angler-robotics/angler-electrical/Hardware/V2/Block Diagrams/PDB.png

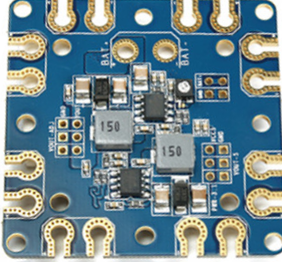
Hardware/V2/Block Diagrams/PDB.png
