angler-robotics/angler-electrical/Hardware/V2/Block Diagrams/XT60 plug.png

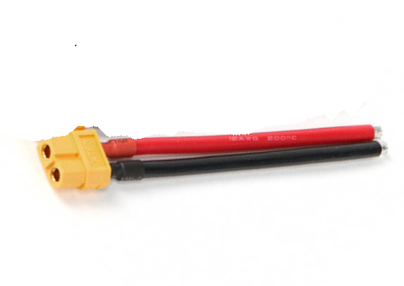
Hardware/V2/Block Diagrams/XT60 plug.png
