angler-robotics/angler-electrical/Hardware/V2/Block Diagrams/Block DiagramV2.pdf

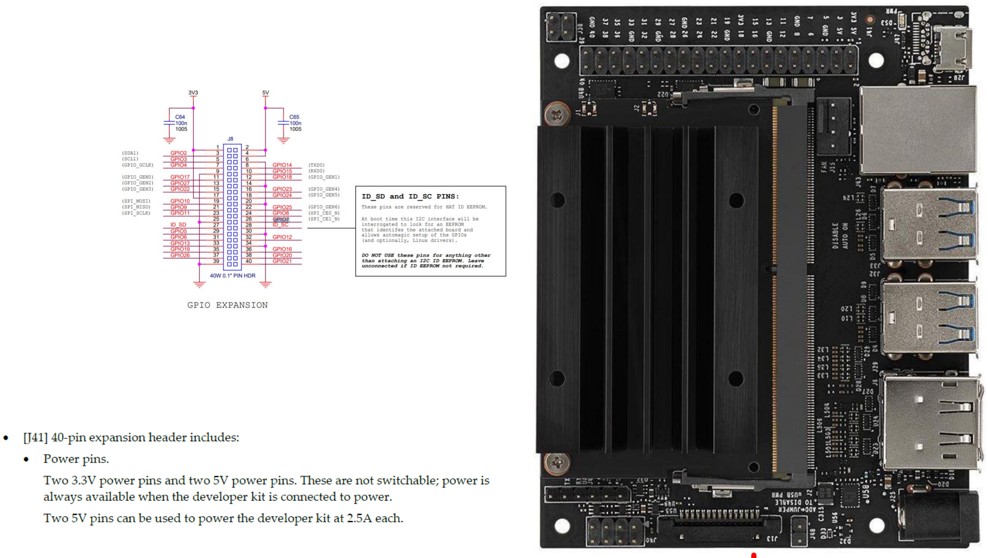
[picture p3: figure]

T100 Thruster | T100 Thruster | T100 Thruster | T100 Thruster | T100 Thruster | T100 Thruster

14.8V 8000mAh 4S1P 30C8000mAh 4S1P 30C

14.8V 8000mAh 4S1P 30C8000mAh 4S1P 30C

XT90 Parallel Adapter

### 2 male inputs 1 female

output

ESC | ESC | ESC | ESC | ESC | ESC

To Proto
Board

# AquaDrone Electrical Block Diagram V2

Power Distribution
Board

XT90 Male Wire Plug

Solder to BAT+ and
BAT- Thru Hole use
10AWG wires

Use bullet
connectors
3x

Use bullet
connectors
3x

Use bullet
connectors
3x

Use bullet
connectors
3x

Use bullet
connectors
3x

Use bullet
connectors
3x

XT60
Male
Wire
Plug

Solder

XT60
Male
Wire
Plug

Solder

XT60
Male
Wire
Plug

Solder

XT60
Male
Wire
Plug

Solder

XT60
Male
Wire
Plug

Solder

XT60
Male
Wire
Plug

Solder

XT60 Female Wire Plug

XT60 Female Wire Plug

XT60 Female Wire Plug

XT60 Female Wire Plug

XT60 Female Wire Plug

To Proto
Board

To Proto
Board

To Proto
Board

To Proto
Board

To Proto
Board

Jetson Nano Dev Kit

H3AAH-4006G

XT60
Plug

Wire

Male

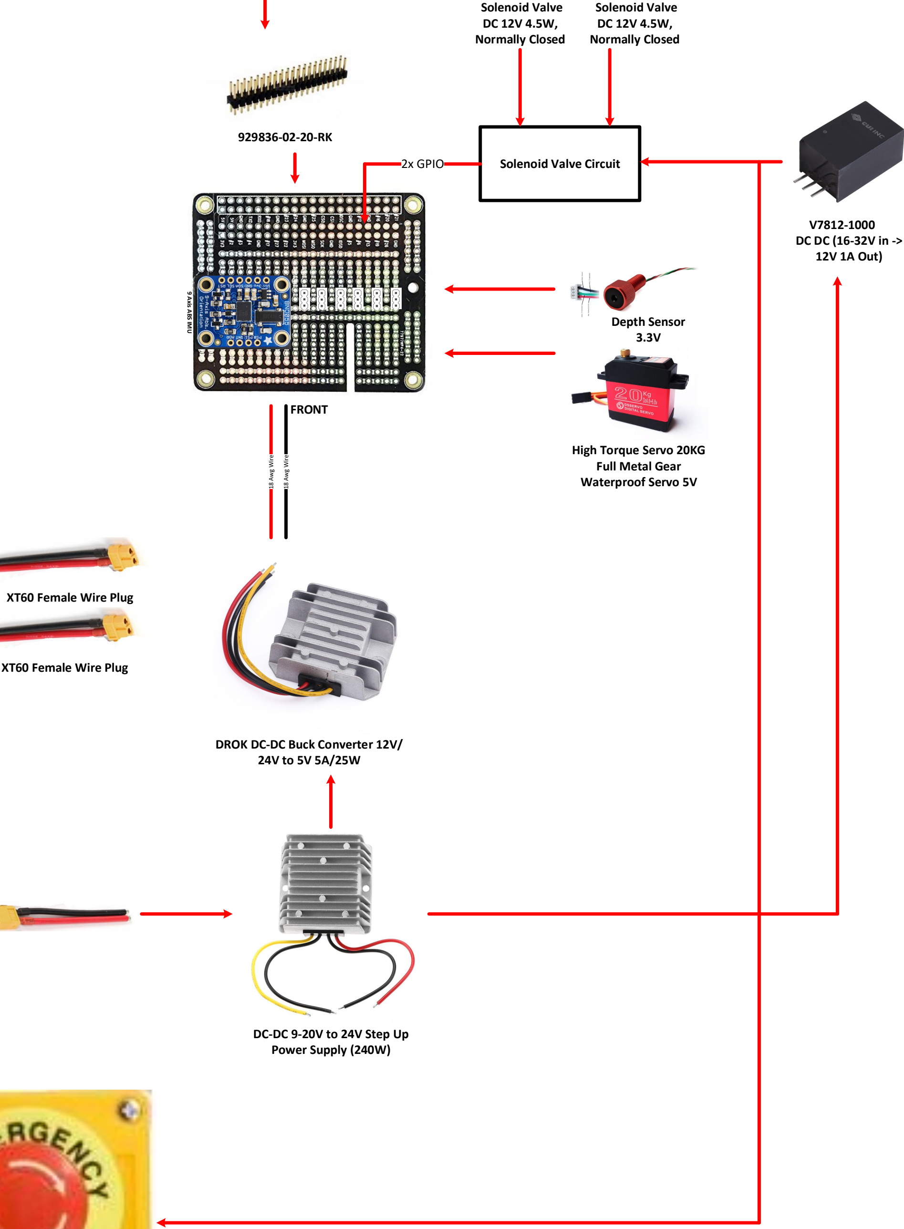
[picture p4: figure]
Depth Sensor 3.3V; XT60 Female Wire Plug; FRONT; 9 Axis ABS IMU; DROK DC-DC Buck Converter 12V/; High Torque Servo 20KG Full Metal Gear Waterproof Servo 5V; 2x GPIO; Solenoid Valve Circuit; V7812-1000 DC DC (16-32V in -> 12V 1A Out); Solenoid Valve DC 12V 4.5W, Normally Closed; DC-DC 9-20V to 24V Step Up Power Supply (240W)

# 24V to 5V 5A/25W ¹⁸ Awg Wire 18 Awg Wire

ZED Mini 5V / 380mA

USB 3.0

Jetson Is powered by the 2 5V pins on the

### 40 Piin header (each can draw 2.5A)

USB 2.0

Digital Battery Capacity
Checker

Digital Battery Capacity
Checker

Fuse + Fuse
Holder

Solder Solder

Fuse + Fuse
Holder

Solder Solder

Fuse + Fuse
Holder

Solder Solder

Fuse + Fuse
Holder

Solder Solder

Fuse + Fuse
Holder

Solder Solder

Fuse + Fuse
Holder

Solder Solder

H2a Hydrophone 3.5mm TRS audio cable

12V 100A Heavy Duty
Split Charge ON/OFF
Relay

Estop Button use NC (dpst) contacts

UGREEN USB
External Stereo
Sound Adapter 96
Khz
