angler-robotics/angler-electrical/Hardware/V1/Research/Battery Parameters.xlsx

# of Motors | 6
Max current draw per motor (A) | 12.5
Total current draw for motors (A) | 75
Curernt draw for other electronics (A) | 5 | I am being conservative here, 5A is more than what we will actaully need (1A will be our goal)
Total Current draw of the system (A) | 80
Number of Lipo cells | 4
Nominal Voltage (V) | 14.8
C Rating | 30
Mah Rating (MAh) | 8000 | Increase this number and flight time goes up
Max current draw that the Lipo can handle (A) | 240
%of load you will actaully use during normal operation | 30%
Flight Time/battery pack (min) | 20
#of battery packs | 2
Total Flight time (Min) | 40
Max power consumption (watts) | 1184 | this is important when choosing cable and wire guages
