angler-robotics/angler-electrical/Hardware/V2/Block Diagrams/Jetson nano.jpg

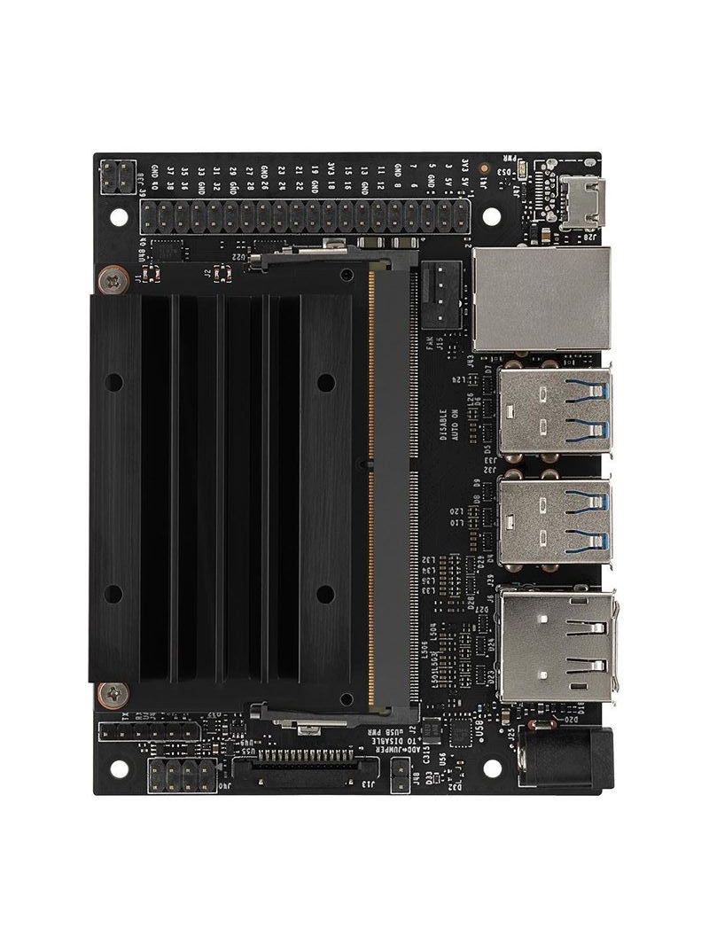
Hardware/V2/Block Diagrams/Jetson nano.jpg
