angler-robotics/angler-electrical/Hardware/V2/Block Diagrams/Motor.png

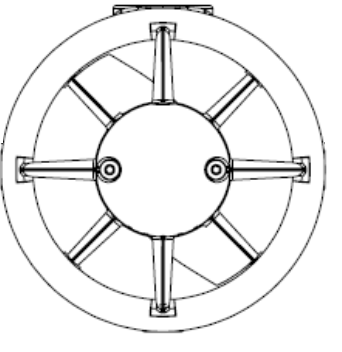
Hardware/V2/Block Diagrams/Motor.png
