angler-robotics/angler-electrical/Hardware/V2/Block Diagrams/Proto board connection.png

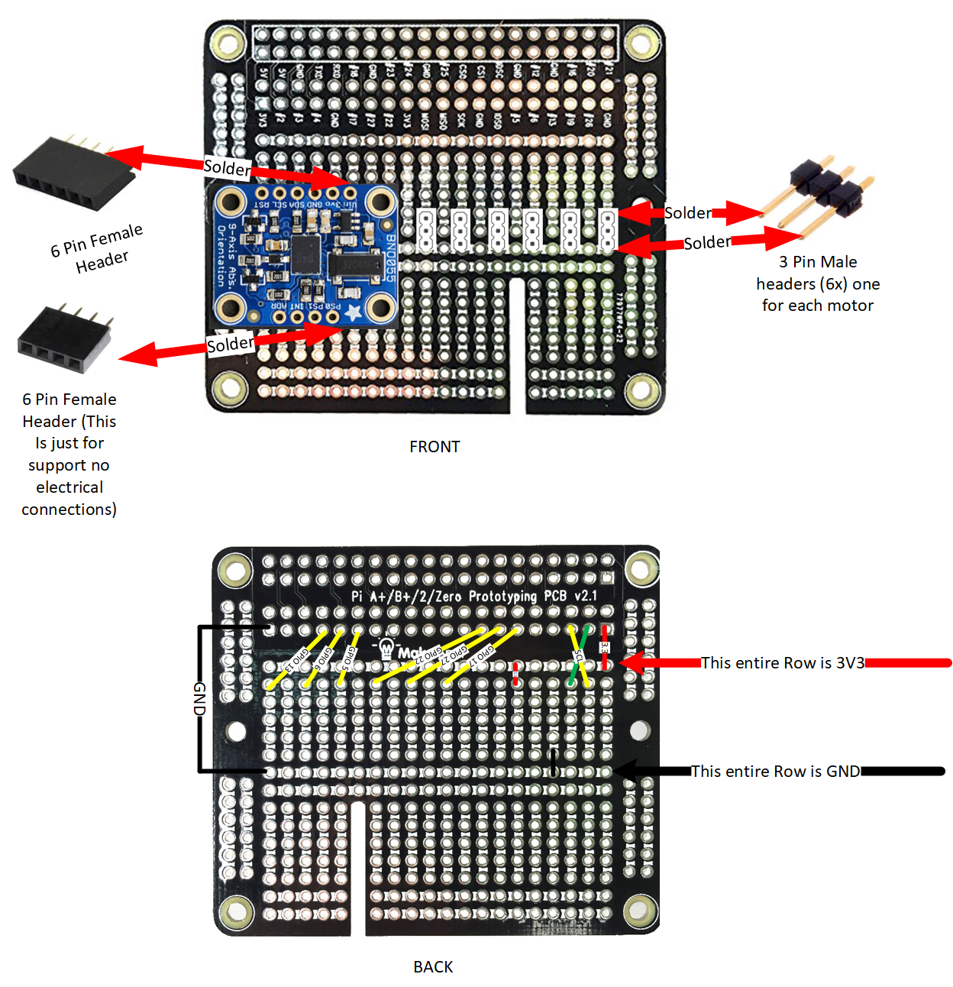
Hardware/V2/Block Diagrams/Proto board connection.png
