angler-robotics/angler-electrical/Hardware/V2/Block Diagrams/XT90 plug.png

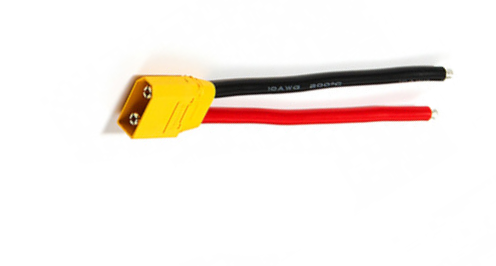
Hardware/V2/Block Diagrams/XT90 plug.png
