angler-robotics/angler-electrical/Hardware/V2/Main PCB V2/BOM/Angler_Main_PCB_V2.xlsx

PCB V2 BOM
Quantity | Designator | VALUE | MFG | MFG_PART_NO | Description | NOSTUFF | COST | Notes
1 | C1 | 4.7uF | Murata Electronics | GRM219R6YA475KA73D | CAP CER 4.7UF 35V X5R 0805 |  | 0.4
1 | C10 | 0.1uF | Yageo | CC0603KRX7R8BB104 | CAP CER 0.1UF 25V X7R 0603 |  | 0.14
1 | C11 | 2nF | Yageo | CC0603KRX7R9BB202 | CAP CER 2000PF 50V X7R 0603 |  | 0.14
1 | C12 | 750pF | Yageo | CC0603KRX7R9BB751 | CAP CER 750PF 50V X7R 0603 |  | 0.16
1 | C4 | 330uF | KEMET | ESL337M025AGMAA | CAP ALUM 330UF 20% 25V TH |  | 0.53
1 | C5 | 47nF | Yageo | CC0603KRX7R9BB473 | CAP CER 0.047UF 50V X7R 0603 |  | 0.14
1 | C8 | 22uF | Taiyo Yuden | TMK325B7226KMHP | CAP CER 22UF 25V X7R 1210 |  | 1.55 | Alternative C1210C226K4PACTU
1 | D6 | 100V 5A | Vishay | VSSAF510-M3/H | DIODE SCHOTTKY 100V 5A DO221AC |  | 0.55
1 | J13 | CONN HEADER VERT 40POS | Amphenol | 67997-140HLF | CONN HEADER VERT 40POS 2.54MM |  |  | Already Have
1 | J18 | 0705530002 | Molex | 0705530002 | CONN HEADER R/A 3POS 2.54MM |  | 1.47
1 | J25 | HEADER VERT 7POS | Wurth Electronics Inc. | 61300711121 | CONN HEADER VERT 7POS 2.54MM |  |  | Already Have
1 | J9 | Jetson Nano 40 Pin | Jetson | Nano | Jetson Nano 40 Pin Interface |  |  | Already Have
1 | L1 | 9.654µH | Eaton | DRQ125-100-R | INDUCT ARRAY 2 COIL 9.654UH SMD |  | 3.15
1 | R17 | 5K62 | Yageo | RC0603FR-075K62L | RES SMD 5.62K OHM 1% 1/10W 0603 |  | 0.15
1 | R18 | 84.5K | Yageo | RC0603FR-0784K5L | RES SMD 84.5K OHM 1% 1/10W 0603 |  | 0.15
1 | R19 | 1K07 | Yageo | RC0603FR-071K07L | RES SMD 1.07K OHM 1% 1/10W 0603 |  | 0.15
1 | R22 | 348R | Yageo | RC0603FR-07348RL | RES SMD 348 OHM 1% 1/10W 0603 |  | 0.15 | Alternative ‎ERJ-3EKF3480V‎
1 | R23 | 36K | Yageo | RC0603FR-0736KL | RES SMD 36K OHM 1% 0.15W 0603 |  | 0.15
1 | R24 | 0R013 | Susumu | PRL1632-R013-F-T1 | RES 0.013 OHM 1W 1206 WIDE |  | 1
1 | R65 | 4.53K | Yageo | RC0603FR-074K53L | RES SMD 4.53K OHM 1% 1/10W 0603 |  | 0.15
1 | SW1 | 100A 12VDC | Omron | G7EB-1A DC12 | RELAY GEN PURPOSE SPST-NO 100A 12VDC |  | 42.86
1 | U1 | BNO055 | Adafruit Industries LLC | BNO055 | IC BNO055 |  |  | Already Have
1 | U2 | DC DC 0.8-6V 10A | TI | LMZ12010TZ/NOPB | DC DC CONVERTER 0.8-6V 10A |  | 24.09
1 | U3 | LM3488MM/NOPB | TI | LM3488MM/NOPB | IC REG CTRLR MULT TOP 8VSSOP |  | 3.29
1 | U4 | DC DC CONVERTER 3.3V 2W | Recom Power | R-78E3.3-0.5 | DC DC CONVERTER 3.3V 2W |  | 3.86
1 | U6 | PCA9685PW,112 | NXP USA Inc. | PCA9685PW,112 | IC LED DRVR LIN DIM 25MA 28TSSOP |  | 3.46
2 | C7, C13 | 0.47uF | Samsung | CL10B474KO8NNNC | CAP CER 0.47UF 16V X7R 0603 |  | 0.14
2 | J1, J10 | XT90-M | DFRobot | FIT0588 | CONN XT90 MALE |  |  | Already Have
2 | J22, J26 | HEADER VERT 3POS | Wurth Electronics Inc. | 61300311121 | CONN HEADER VERT 3POS 2.54MM |  |  | Already Have
2 | J7, J11 | LiPo Cells (JST-XH) | JST Sales America Inc. | S5B-XH-A(LF)(SN) | CONN HEADER R/A 5POS 2.5MM |  | 0.43
2 | R28, R29 | 127K | Vishay Dale | CRCW0603127KFKEA | RES SMD 127K OHM 1% 1/10W 0603 |  | 0.15
2 | R36, R37 | 86.6K | Yageo | RC0603FR-0786K6L | RES SMD 86.6K OHM 1% 1/10W 0603 |  | 0.15
2 | R43, R44 | 47K | Yageo | RC0603FR-0747KL | RES SMD 47K OHM 1% 1/10W 0603 |  | 0.15
3 | C2, C3, C9 | 33uF | Nichicon | UPM2A330MPD1TD | CAP ALUM 33UF 20% 100V RADIAL |  | 0.18
3 | U5, U7, U8 | MCP3424-E/SL | Microchip Technology | MCP3424-E/SL | IC ADC 18BIT SIGMA-DELTA 14SOIC |  | 5.98
4 | LED1, LED2, LED3, LED4 | GREEN 0805 | Würth Elektronik | 150080VS75000 | LED GREEN CLEAR 0805 SMD |  | 0.26
6 | C14, C15, C17, C18, C21, C23 | 10uF | KEMET | C1608X5R1E106M080AC | CAP CER 10UF 25V X5R 0603 |  | 0.14 | Alternative ‎CL10A106MA8NRNC‎
6 | D1, D2, D3, D4, D5, D7 | S1GTR | SMC Diode Solutions | S1GTR | DIODE GEN PURP 400V 1A SMA |  | 0.17
6 | Q1, Q2, Q3, Q4, Q5, Q6 | 16mOhm @ 20A, 10V | ON Semiconductor | NTD5865NLT4G | MOSFET N-CH 60V 46A DPAK |  | 0.97
6 | R21, R71, R72, R75, R77, R79 | 100R | Yageo | RC0603FR-07100RL | RES SMD 100 OHM 1% 1/10W 0603 |  | 0.15
6 | U9, U10, U11, U12, U13, U14 | SN74LVC1G97DBVR | TI | SN74LVC1G97DBVR | IC CONFIG MULT-FUNC GATE SOT23-6 |  | 0.58
7 | R30, R33, R50, R57, R60, R68, R70 | 10K | Vishay Dale | CRCW060310K0FKEA | RES SMD 10K OHM 1% 1/10W 0603 | DNP |  | DNP
8 | ESC1, ESC2, ESC3, ESC4, ESC5, ESC6, ESC7, ESC8 | Basic ESC | Blue Robotics | BESC30-R3 | Basic ESC
8 | FH1, FH2, FH3, FH4, FH5, FH6, FH7, FH8 | Fuse Holder | Schurter Inc. | 0031.8231 | FUSE BLOK CARTRIDGE 600V 16A PCB |  | 2.89
8 | J2, J3, J4, J5, J6, J14, J16, J19 | 0705530001 | Molex | 0705530001 | CONN HEADER R/A 2POS 2.54MM |  | 1.12
8 | J8, J12, J15, J17, J20, J21, J23, J24 | TERM BLK 3 POS | TE Connectivity | 282834-3 | TERM BLK 3P SIDE ENT 2.54MM PCB |  | 2.9
8 | R14, R15, R40, R41, R42, R45, R46, R47 | 0R | Panasonic | ERJ-6GEY0R00V | RES SMD 0 OHM JUMPER 1/8W 0805 | DNP |  | DNP
8 | R31, R32, R38, R39, R48, R49, R63, R64 | 28.7K | Yageo | RC0603FR-0728K7L | RES SMD 28.7K OHM 1% 1/10W 0603 |  | 0.15
9 | R1, R2, R3, R4, R5, R6, R7, R8, R9 | 0R | Panasonic | ERJ-6GEY0R00V | RES SMD 0 OHM JUMPER 1/8W 0805 |  | 0.15
10 | C16, C19, C20, C22, C24, C25, C26, C27, C28, C29 | 0.1uF | KEMET | C0603C104M4RACTU | CAP CER 0.1UF 16V X7R 0603 |  | 0.14
29 | R10, R11, R12, R13, R16, R20, R25, R26, R27, R34, R35, R51, R52, R53, R54, R55, R56, R58, R59, R61, R62, R66, R67, R69, R73, R74, R76, R78, R80 | 10K | Vishay Dale | CRCW060310K0FKEA | RES SMD 10K OHM 1% 1/10W 0603 |  | 0.15
 |  |  |  |  | TOTAL |  | 184.89
