angler-robotics/angler-electrical/Hardware/V2/Main PCB V1/Traces-1.27mm Thick-Copper.DXF

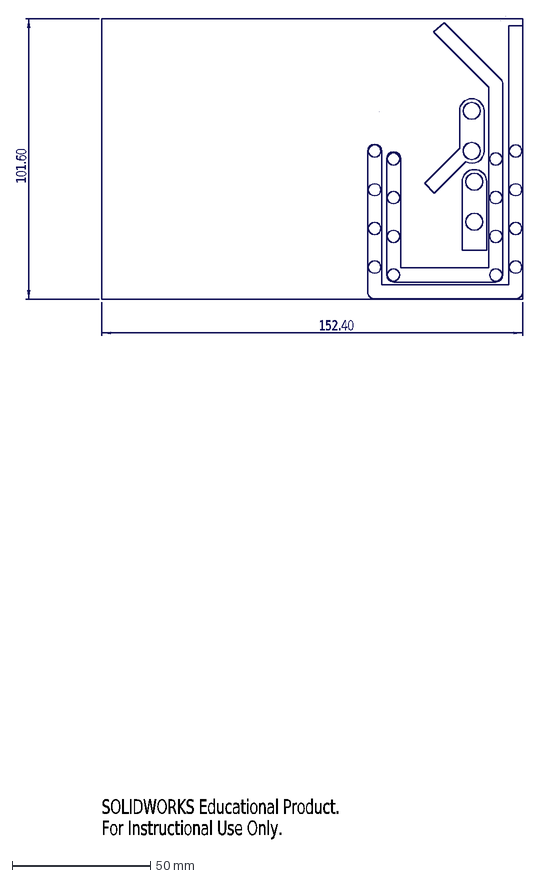
[picture p9: CAD file, 2020-01-24, an earlier design]
Hardware/V2/Main PCB V1/Traces-1.27mm Thick-Copper.DXF
152.40
101.60
SOLIDWORKS Educational Product.
For Instructional Use Only.
