angler-robotics/angler-electrical/(list of files, cad)

Other CAD files:
Hardware/V2/Main PCB V1/Traces-1.27mm Thick-Copper.SLDDRW
