angler-robotics/angler-electrical/Testing/Motor PWM Width - Thrust Relation.xlsx

PWM Signal Width | Thrust (pounds) | RPM | Thrust (kg)
1100 | -3.89 | 2869 | -1.768181818
1110 | -3.61 | 2987 | -1.640909091
1120 | -3.47 | 3110 | -1.577272727
1130 | -3.36 | 3061 | -1.527272727
1140 | -3.17 | 3057 | -1.440909091
1150 | -3.08 | 3184 | -1.4
1160 | -2.91 | 3810 | -1.322727273
1170 | -2.77 | 3841 | -1.259090909
1180 | -2.66 | 3771 | -1.209090909
1190 | -2.56 | 3690 | -1.163636364
1200 | -2.43 | 3631 | -1.104545455
1210 | -2.29 | 3571 | -1.040909091
1220 | -2.18 | 3497 | -0.990909091
1230 | -2.04 | 3411 | -0.927272727
1240 | -1.88 | 3321 | -0.854545455
1250 | -1.74 | 3241 | -0.790909091
1260 | -1.66 | 3141 | -0.754545455
1270 | -1.55 | 3071 | -0.704545455
1280 | -1.47 | 2960 | -0.668181818
1290 | -1.37 | 2871 | -0.622727273
1300 | -1.28 | 2771 | -0.581818182
1310 | -1.17 | 2653 | -0.531818182
1320 | -1.04 | 2531 | -0.472727273
1330 | -0.94 | 2430 | -0.427272727
1340 | -0.88 | 2311 | -0.4
1350 | -0.81 | 2201 | -0.368181818
1360 | -0.72 | 2090 | -0.327272727
1370 | -0.6 | 1961 | -0.272727273
1380 | -0.51 | 1831 | -0.231818182
1390 | -0.44 | 1711 | -0.2
1400 | -0.37 | 1586 | -0.168181818
1410 | -0.31 | 1440 | -0.140909091
1420 | -0.23 | 1278 | -0.104545455
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
