angler-robotics/angler-electrical/Hardware/V2/Main PCB V2/WBDesign4.pdf

## WEBENCH ® Design Report

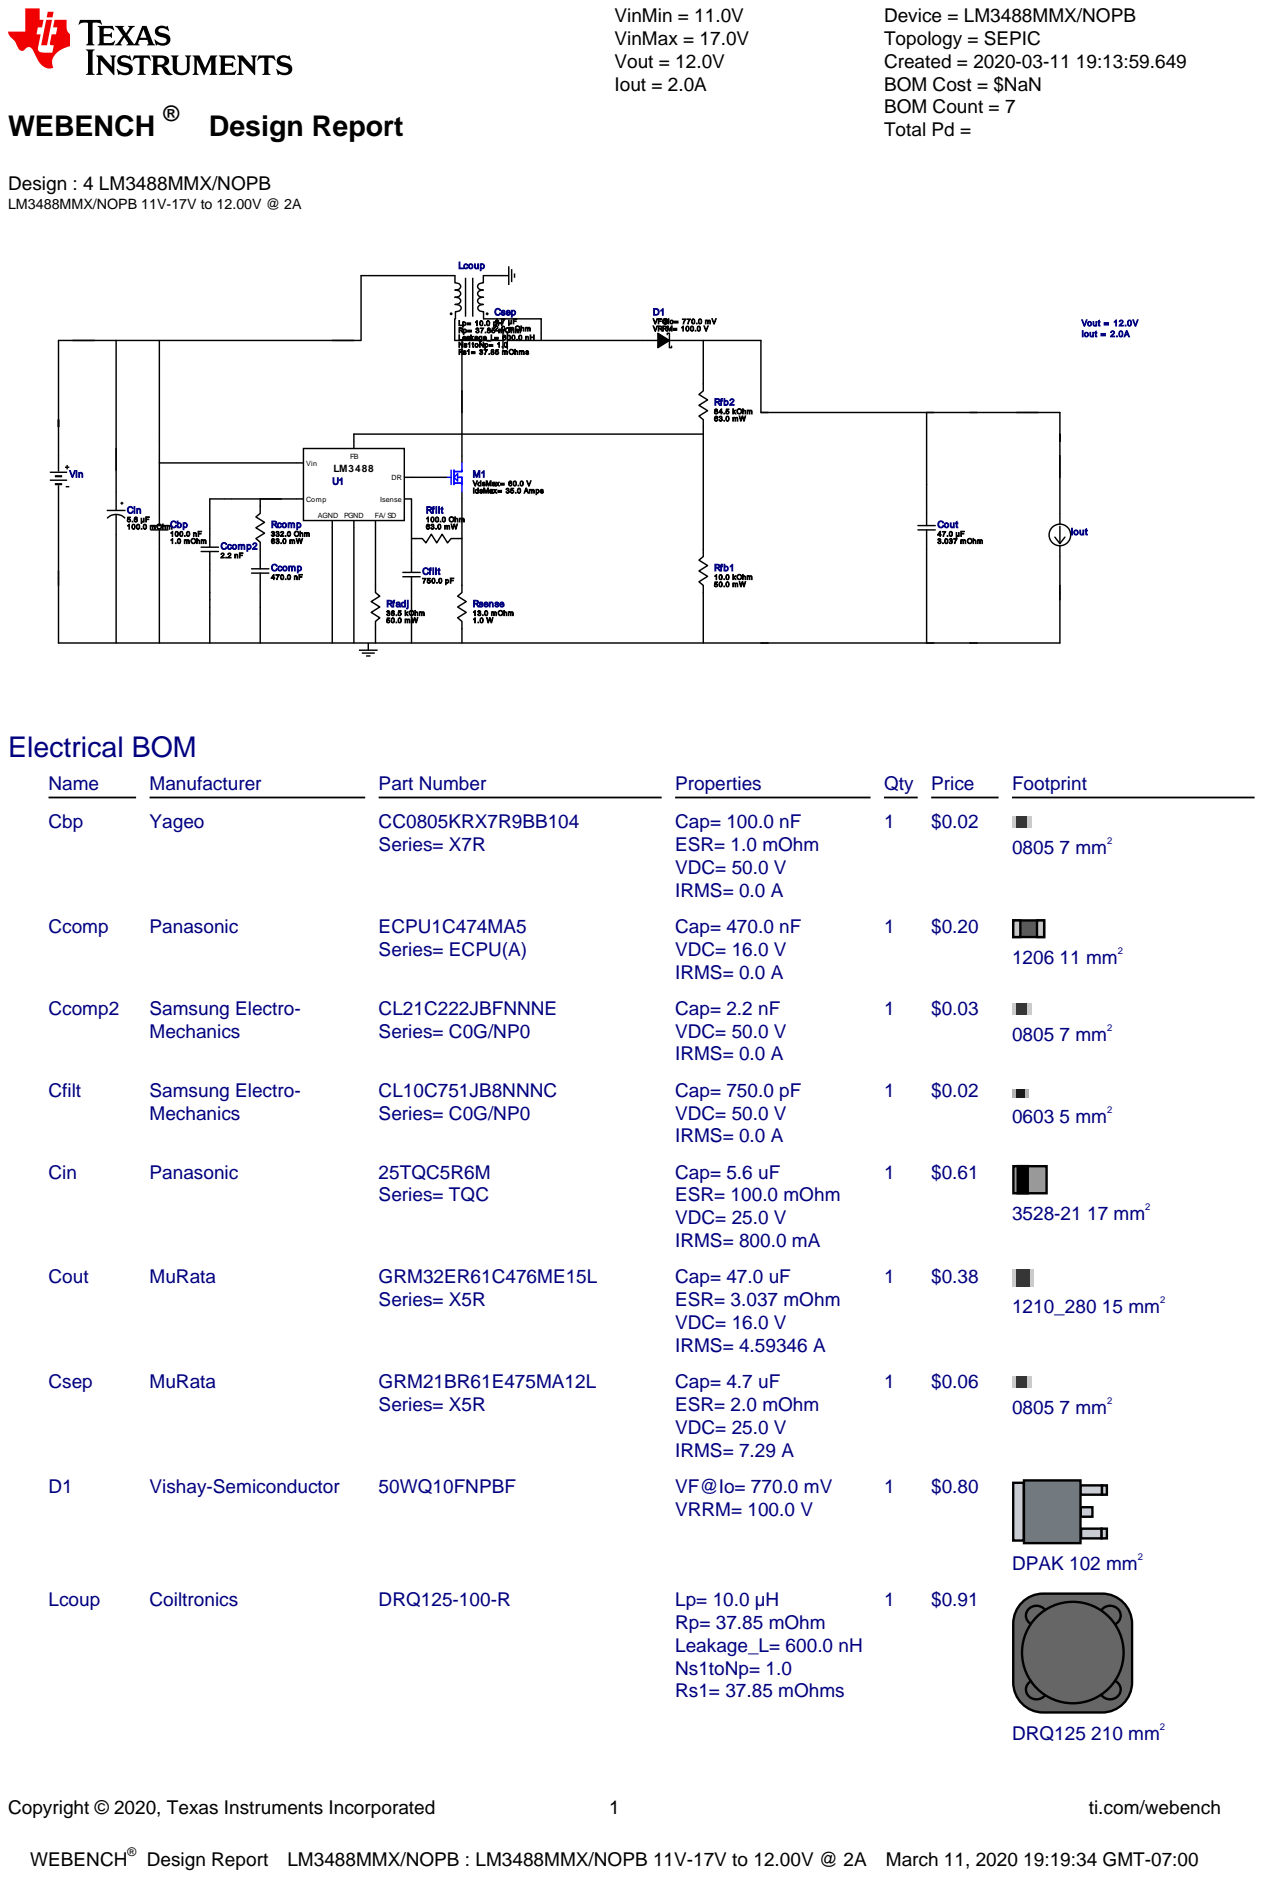
[picture p10: page 1]
Copyright © 2020, Texas Instruments Incorporated; ti.com/webench; WEBENCH®; Design : 4 LM3488MMX/NOPB LM3488MMX/NOPB 11V-17V to 12.00V @ 2A; VinMin = 11.0V VinMax = 17.0V Vout = 12.0V Iout = 2.0A; Cin 5.6 µF 100.0 mOhmCbp 100.0 nF 1.0 mOhm; Vout = 12.0V Iout = 2.0A; Cout 47.0 µF; 3.037 mOhm; Rfadj 36.5 kOhm; M1 VdsMax= 60.0 V IdsMax= 35.0 Amps; Rfb1 10.0 kOhm 50.0 mW; D1 VF@Io= 770.0 mV VRRM= 100.0 V; PGND; Vin; Comp; AGND; Isense; Ccomp 470.0 nF; Rcomp 332.0 Ohm 63.0 mW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

Device = LM3488MMX/NOPB
Topology = SEPIC
Created = 2020-03-11 19:13:59.649
BOM Cost = $NaN
BOM Count = 7
Total Pd =

Design Report LM3488MMX/NOPB : LM3488MMX/NOPB 11V-17V to 12.00V @ 2A March 11, 2020 19:19:34 GMT-07:00

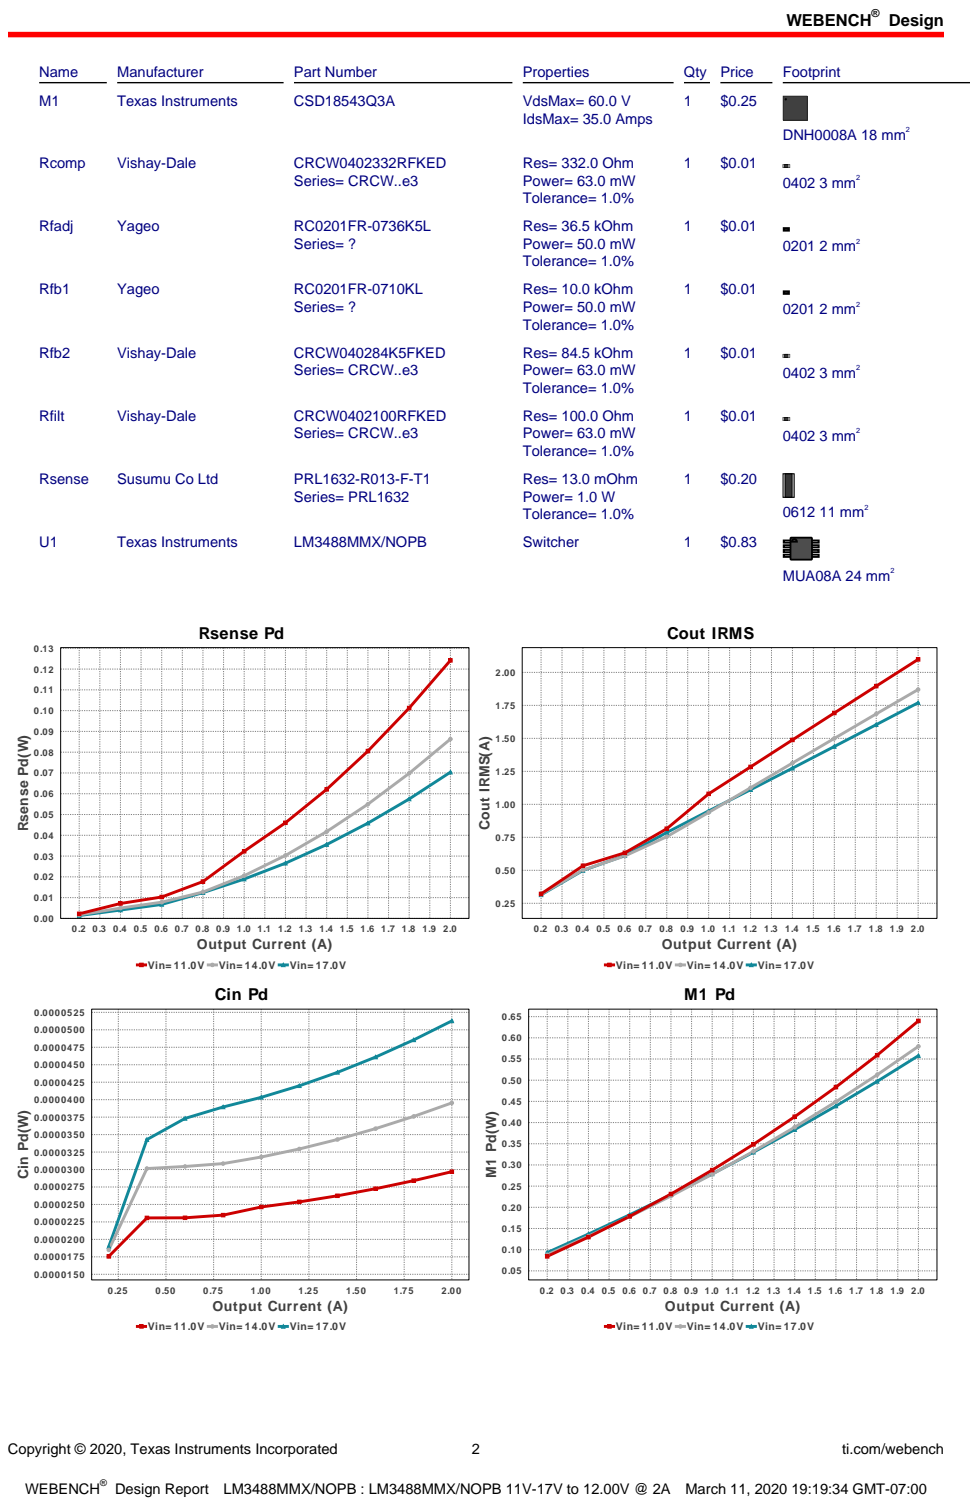
[picture p11: page 2]
Design; Copyright © 2020, Texas Instruments Incorporated; ti.com/webench; Name; Manufacturer; Part Number; Properties; Qty Price; Footprint; Texas Instruments; CSD18543Q3A; VdsMax= 60.0 V; IdsMax= 35.0 Amps; DNH0008A 18 mm²; Rcomp; Vishay-Dale; CRCW0402332RFKED; Series= CRCW..e3; Res= 332.0 Ohm Power= 63.0 mW Tolerance= 1.0%; 0402 3 mm²; Rfadj; Yageo; Series= ?; Res= 36.5 kOhm Power= 50.0 mW Tolerance= 1.0%; 0201 2 mm²; Rfb1; Res= 10.0 kOhm Power= 50.0 mW Tolerance= 1.0%; Rfb2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

Vin= 11.0V Vin= 14.0V Vin= 17.0V

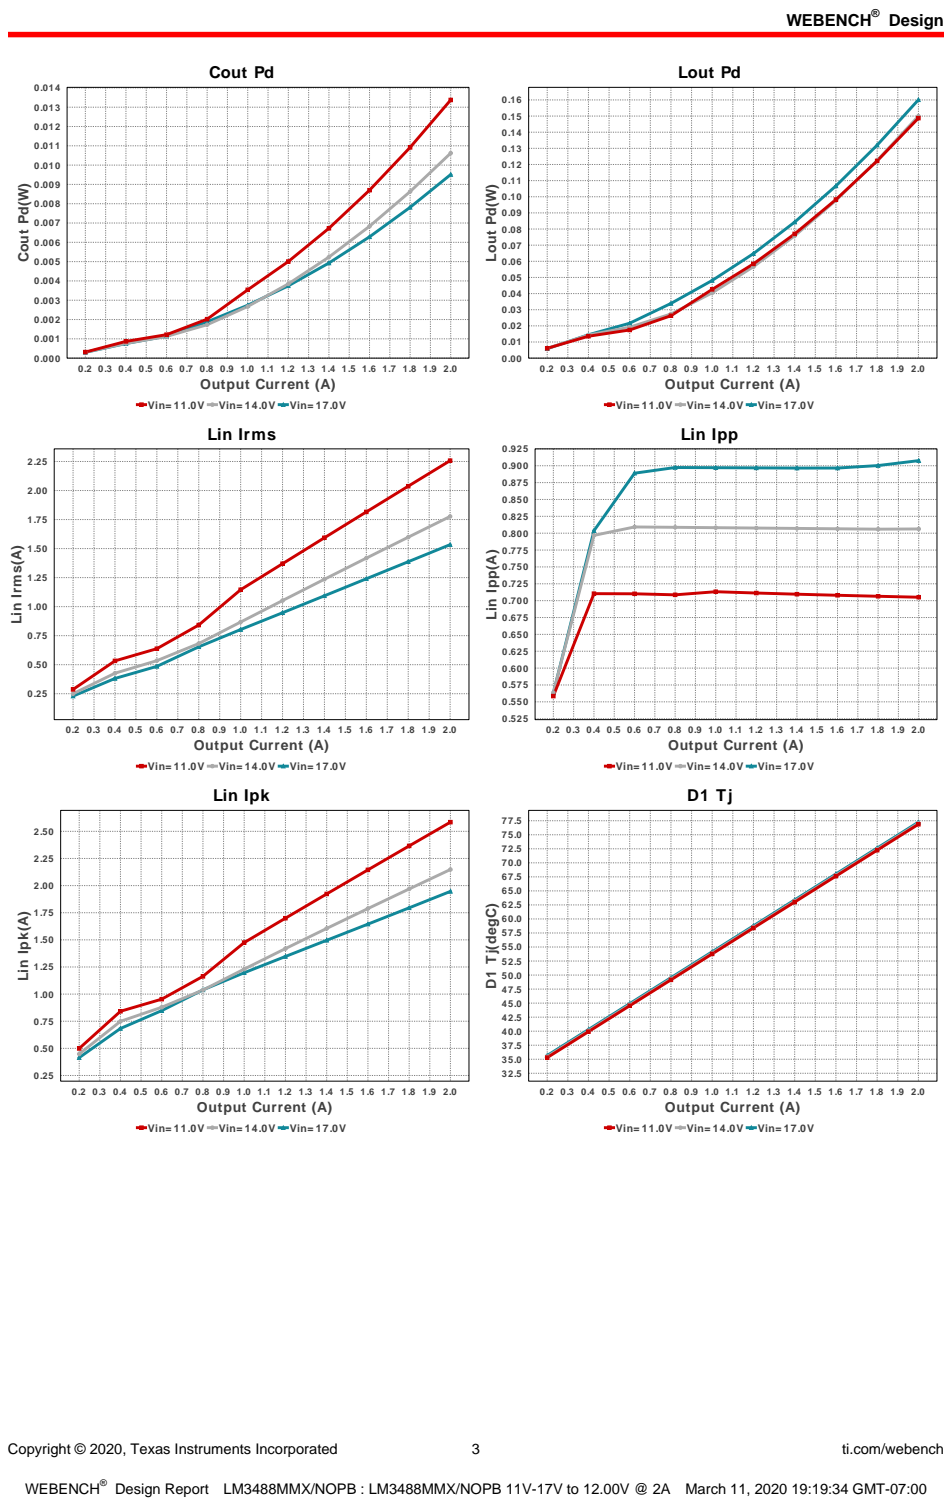
[picture p12: page 3]
Copyright © 2020, Texas Instruments Incorporated; ti.com/webench; Cout Pd; 0.2 0.3 0.4 0.5 0.6 0.7 0.8 0.9 1.0 1.1 1.2 1.3 1.4 1.5 1.6 1.7 1.8 1.9 2.0 Output Current (A); Cout Pd(W); Lout Pd; Lout Pd(W); Lin Irms; Lin Irms(A); Lin Ipp; Lin Ipp(A); Lin Ipk; Lin Ipk(A); D1 Tj(degC)

Vin= 11.0V Vin= 14.0V Vin= 17.0V

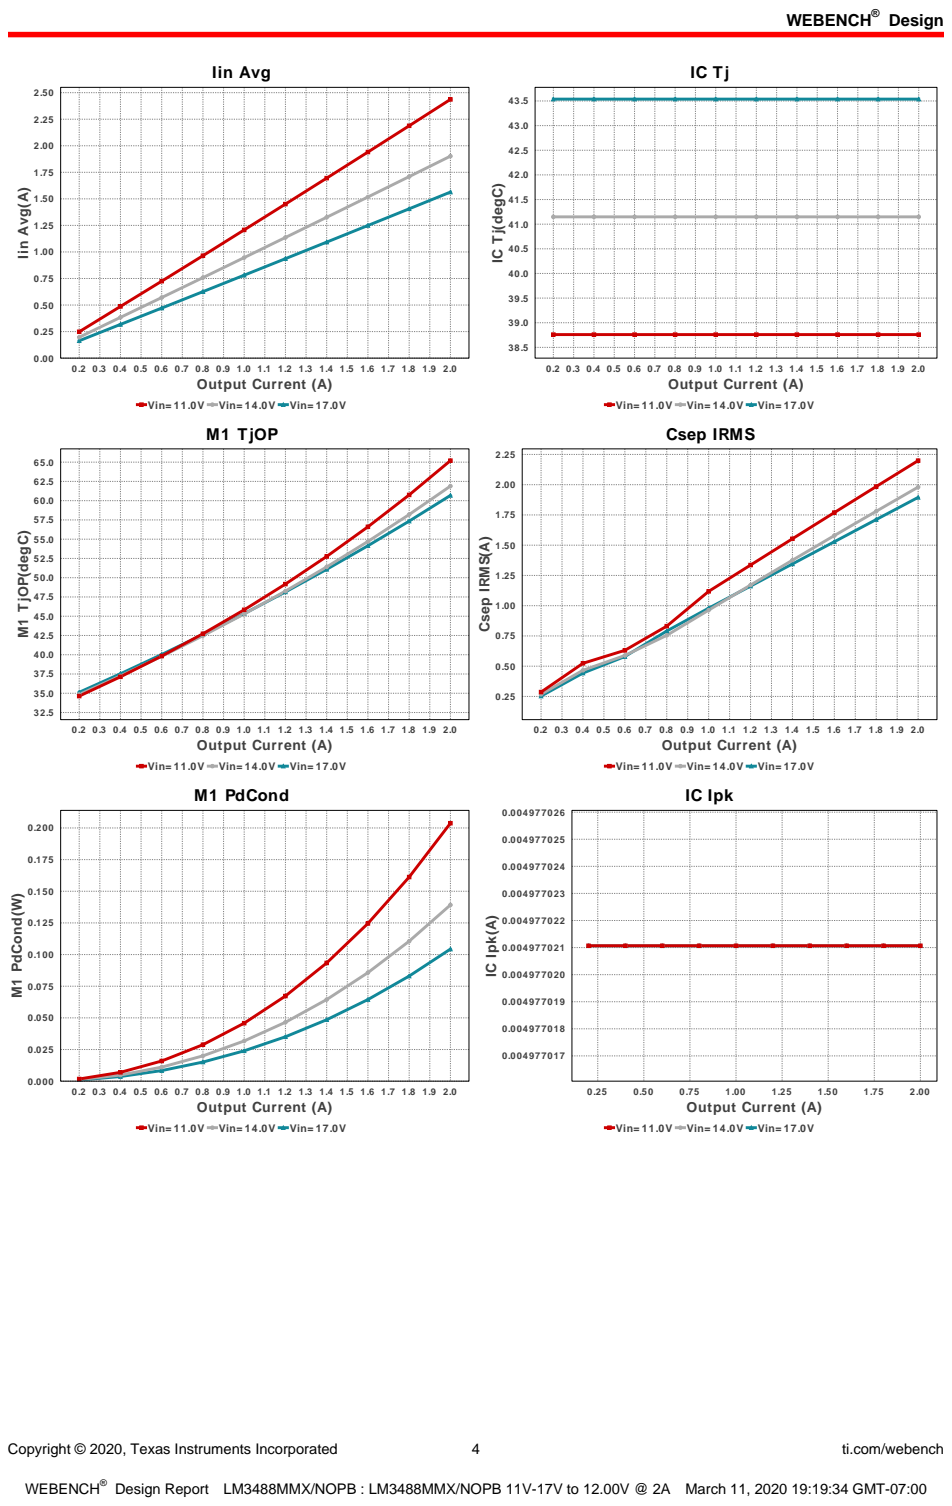
[picture p13: page 4]
Copyright © 2020, Texas Instruments Incorporated; ti.com/webench; Iin Avg; 0.2 0.3 0.4 0.5 0.6 0.7 0.8 0.9 1.0 1.1 1.2 1.3 1.4 1.5 1.6 1.7 1.8 1.9 2.0 Output Current (A); Iin Avg(A); M1 TjOP; M1 TjOP(degC); Csep IRMS(A); M1 PdCond(W); IC Ipk; 2.00 Output Current (A); IC Ipk(A)

IC Tj(degC)

Vin= 11.0V Vin= 14.0V Vin= 17.0V

Csep IRMS

M1 PdCond

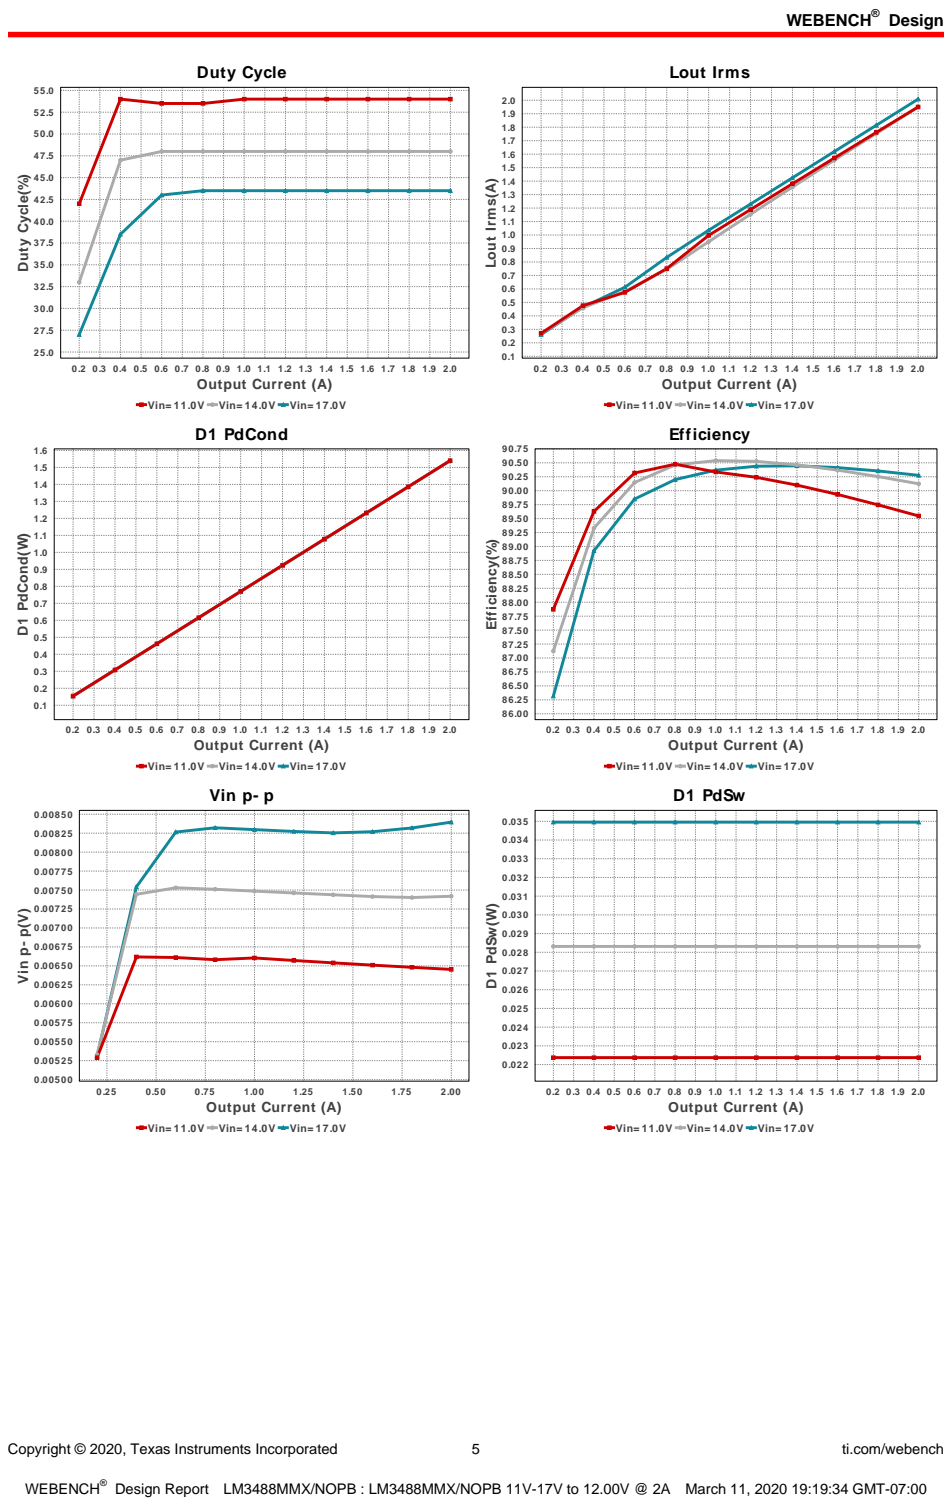
[picture p14: page 5]
Copyright © 2020, Texas Instruments Incorporated; ti.com/webench; Duty Cycle; 0.2 0.3 0.4 0.5 0.6 0.7 0.8 0.9 1.0 1.1 1.2 1.3 1.4 1.5 1.6 1.7 1.8 1.9 2.0 Output Current (A); Duty Cycle(%); Lout Irms; Lout Irms(A); D1 PdCond(W); Efficiency(%); Vin p- p; 2.00 Output Current (A); Vin p- p(V); D1 PdSw(W)

Vin= 11.0V Vin= 14.0V Vin= 17.0V
D1 PdCond

Efficiency

D1 PdSw

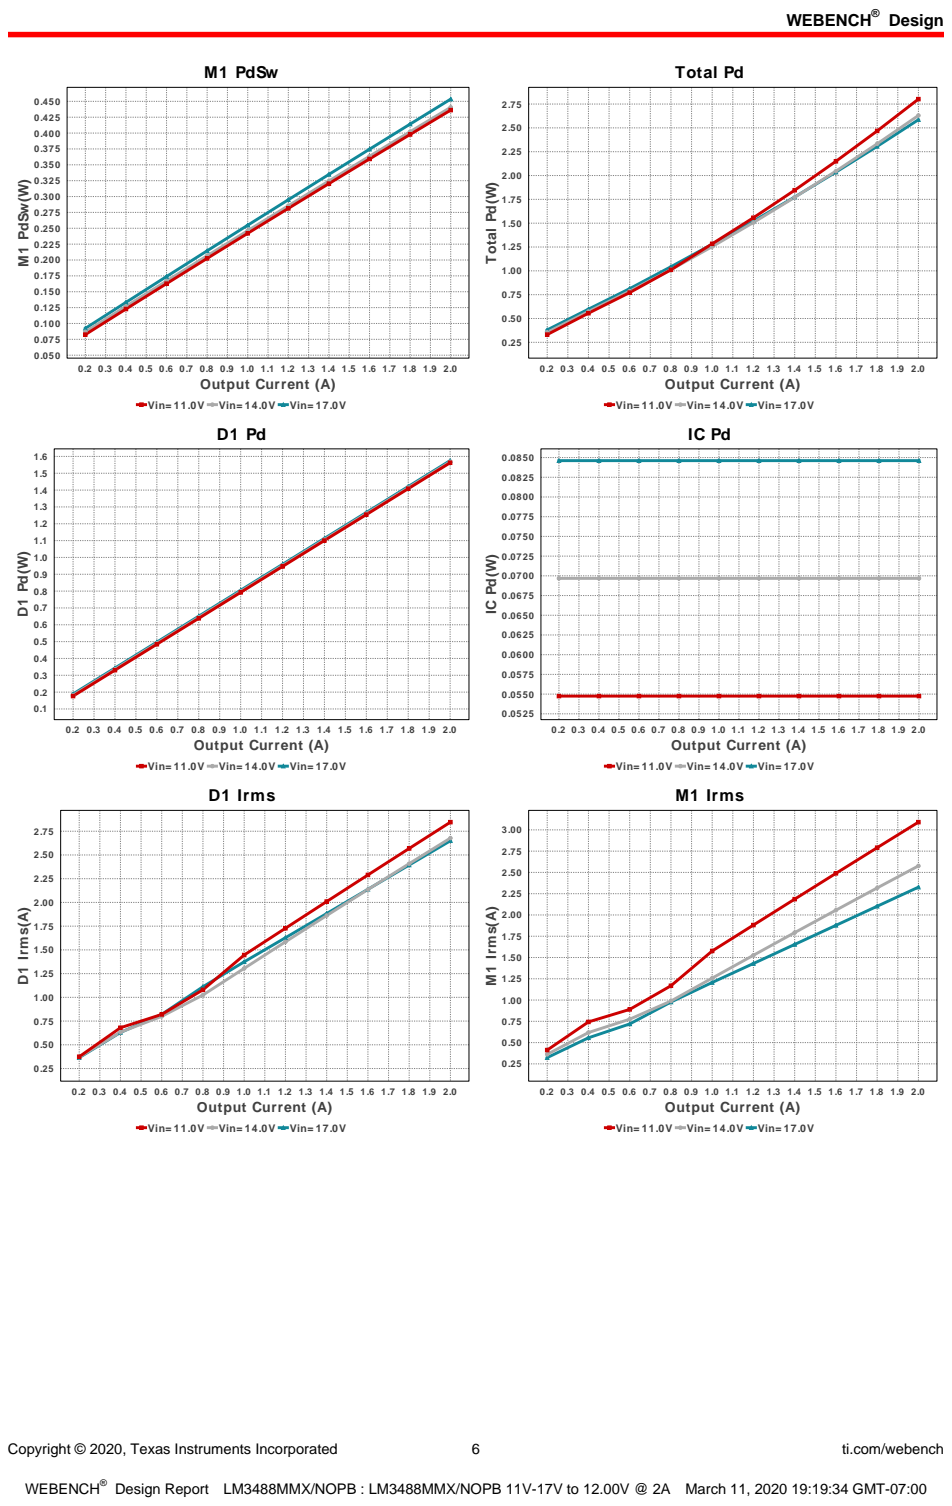
[picture p15: page 6]
Copyright © 2020, Texas Instruments Incorporated; ti.com/webench; M1 PdSw; 0.2 0.3 0.4 0.5 0.6 0.7 0.8 0.9 1.0 1.1 1.2 1.3 1.4 1.5 1.6 1.7 1.8 1.9 2.0 Output Current (A); M1 PdSw(W); Total Pd; Total Pd(W); D1 Irms; D1 Irms(A); M1 Irms; M1 Irms(A)

Vin= 11.0V Vin= 14.0V Vin= 17.0V

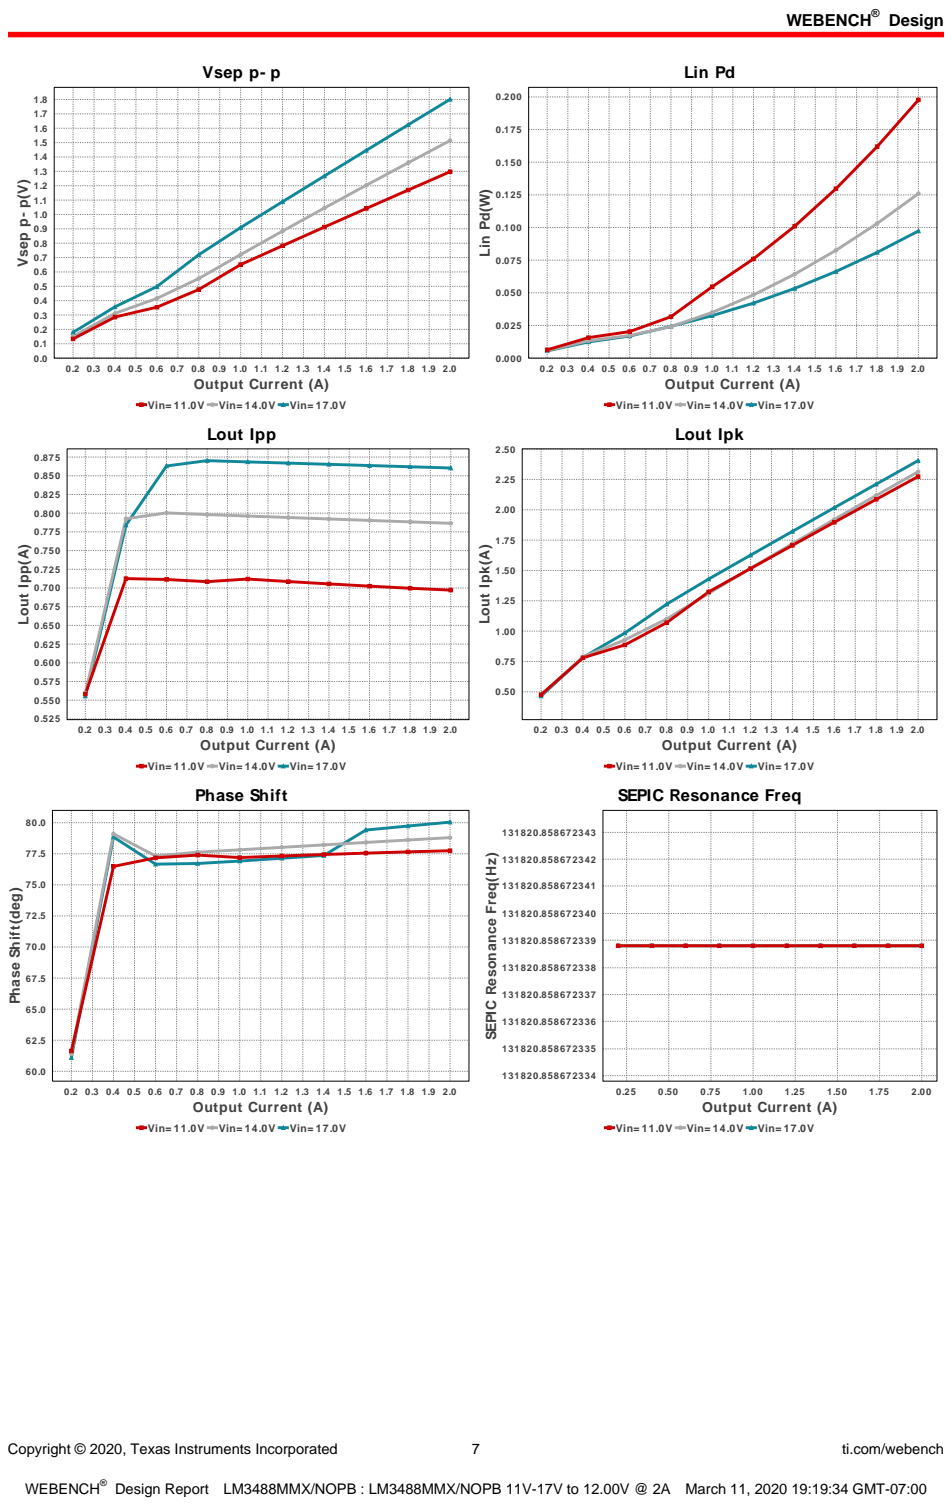
[picture p16: page 7]
Copyright © 2020, Texas Instruments Incorporated; ti.com/webench; Vsep p- p; 0.2 0.3 0.4 0.5 0.6 0.7 0.8 0.9 1.0 1.1 1.2 1.3 1.4 1.5 1.6 1.7 1.8 1.9 2.0 Output Current (A); Vsep p- p(V); Lin Pd; Lin Pd(W); Lout Ipp; Lout Ipp(A); Lout Ipk; Lout Ipk(A); 2.00 Output Current (A)

Vin= 11.0V Vin= 14.0V Vin= 17.0V

Phase Shift

SEPIC Resonance Freq

SEPIC Resonance Freq(Hz)

Phase Shift(deg)

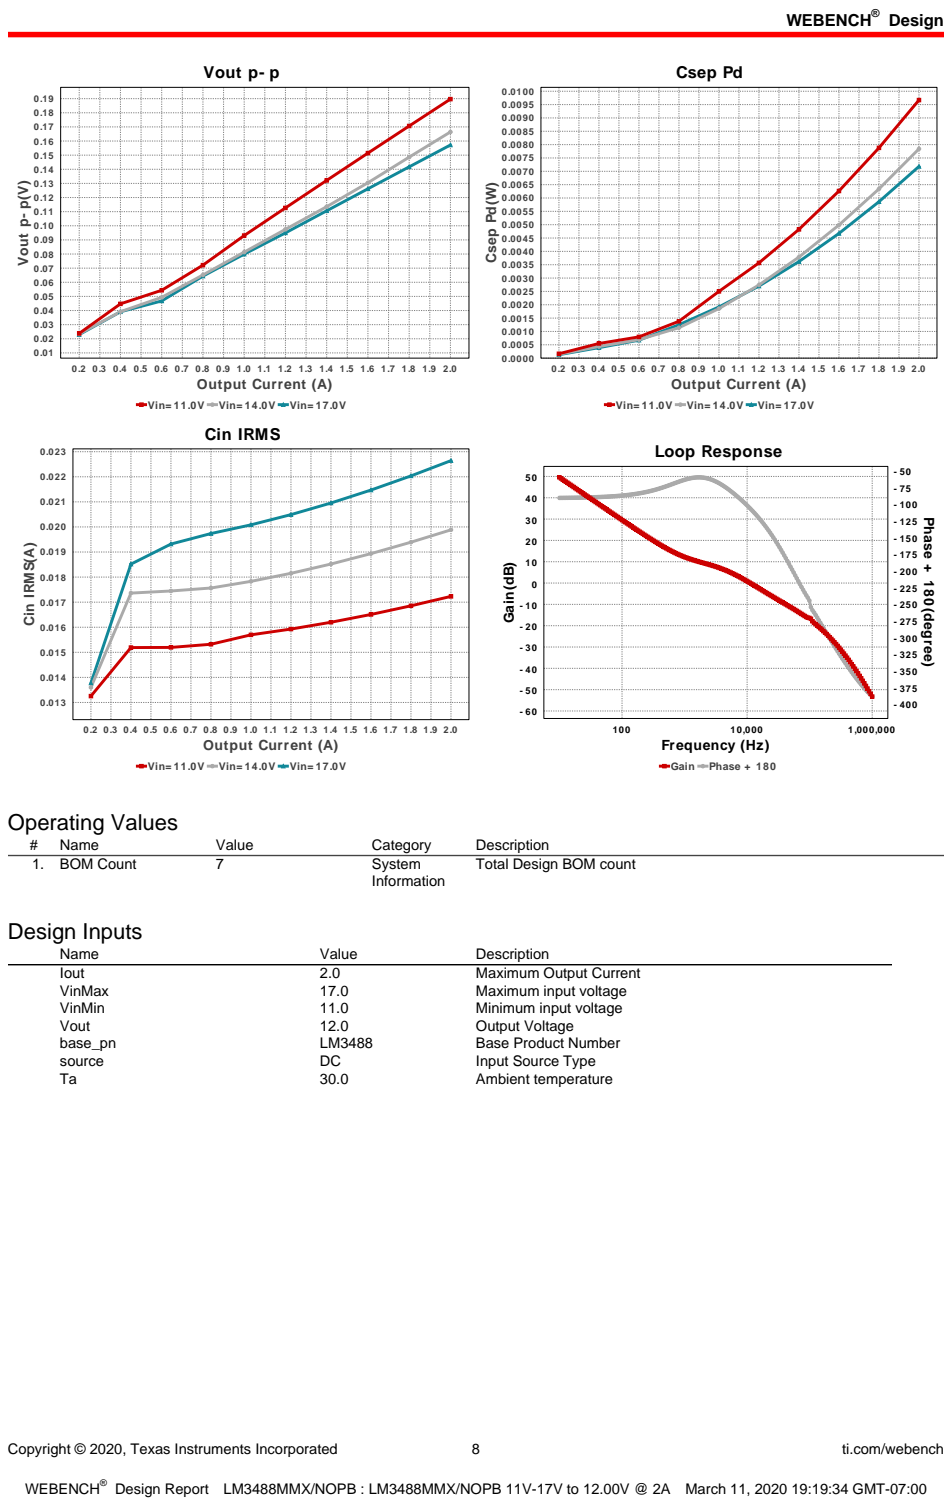
[picture p17: page 8]
Copyright © 2020, Texas Instruments Incorporated; ti.com/webench; Vout p- p; 0.2 0.3 0.4 0.5 0.6 0.7 0.8 0.9 1.0 1.1 1.2 1.3 1.4 1.5 1.6 1.7 1.8 1.9 2.0 Output Current (A); Vout p- p(V); Csep Pd; Csep Pd(W); Cin IRMS(A); Loop Response; Gain Phase + 180; 1,000,000 Frequency (Hz); Gain(dB); Phase + 180(degree); Operating Values; Name; Value; Category; Description; 1. BOM Count; System; Information; Design Inputs; Iout; Maximum Output Current; VinMax; Maximum input voltage; VinMin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

Vin= 11.0V Vin= 14.0V Vin= 17.0V
Cin IRMS

Total Design BOM count


Copyright © 2020, Texas Instruments Incorporated | 9 | ti.com/webench

## Assembly

## Component Testing

Some published data on components in datasheets such as Capacitor ESR and Inductor DC resistance is based on conservative values that will guarantee that the components always exceed the specification. For design purposes it is usually better to work with typical values. Since this data is not always available it is a good practice to measure the Capacitance and ESR values of Cin and Cout, and the inductance and DC resistance of L1 before assembly of the board. Any large discrepancies in values should be electrically simulated in WEBENCH to check for instabilities and thermally simulated in WebTHERM to make sure critical temperatures are not exceeded.

## Soldering Component to Board

If board assembly is done in house it is best to tack down one terminal of a component on the board then solder the other terminal. For surface mount parts with large tabs, such as the DPAK, the tab on the back of the package should be pre-tinned with solder, then tacked into place by one of the pins. To solder the tab town to the board place the iron down on the board while resting against the tab, heating both surfaces simultaneously. Apply light pressure to the top of the plastic case until the solder flows around the part and the part is flush with the PCB. If the solder is not flowing around the board you may need a higher wattage iron (generally 25W to 30W is enough).

## Initial Startup of Circuit

It is best to initially power up the board by setting the input supply voltage to the lowest operating input voltage 11.0V and set the input supply's current limit to zero. With the input supply off connect up the input supply to Vin and GND. Connect a digital volt meter and a load if needed to set the minimum Iout of the design from Vout and GND. Turn on the input supply and slowly turn up the current limit on the input supply.
If the voltage starts to rise on the input supply continue increasing the input supply current limit while watching the output voltage. If the current increases on the input supply, but the voltage remains near zero, then there may be a short or a component misplaced on the board. Power down the board and visually inspect for solder bridges and recheck the diode and capacitor polarities. Once the power supply circuit is operational then more extensive testing may include full load testing, transient load and line tests to compare with simulation results.

## Load Testing

The setup is the same as the initial startup, except that an additional digital voltmeter is connected between Vin and GND, a load is connected between Vout and GND and a current meter is connected in series between Vout and the load. The load must be able to handle at least rated output power + 50% ( 7.5 watts for this design). Ideally the load is supplied in the form of a variable load test unit. It can also be done in the form of suitably large power resistors. When using an oscilloscope to measure waveforms on the prototype board, the ground leads of the oscilloscope probes should be as short as possible and the area of the loop formed by the ground lead should be kept to a minimum. This will help reduce ground lead inductance and eliminate EMI noise that is not actually present in the circuit.

## Design Assistance

1. Master key : 3ADD0724B632D79A[v1]
2. LM3488 Product Folder : http://www.ti.com/product/LM3488 : contains the data sheet and other resources.

Copyright © 2020, Texas Instruments Incorporated | 10 | ti.com/webench

Important Notice and Disclaimer

TI provides technical and reliability data (including datasheets), design resources (including reference designs), application or other design advice, web tools, safety information, and other resources AS IS and with all faults, and disclaims all warranties. These resources are intended for skilled developers designing with TI products. You are solely responsible for (1) selecting the appropriate TI products for your application, (2) designing, validating and testing your application, and (3) ensuring your application meets applicable standards, and any other safety, security, or other requirements.

These resources are subject to change without notice. TI grants you permission to use these resources only for development of an application that uses the TI products described in the resource. Other reproduction and display of these resources is prohibited. No license is granted to any other TI intellectual property right or to any third party intellectual property right. TI disclaims responsibility for, and you will fully indemnify TI and its representatives against, any claims, damages, costs, losses, and liabilities arising out of your use of these resources.

Providing these resources does not expand or otherwise alter TI's applicable Terms of Sale or other applicable terms available either on ti.com or provided in conjunction with TI products.
