angler-robotics/angler-electrical/Hardware/V2/Main PCB V2/WBDesign6.pdf

## WEBENCH ® Design Report

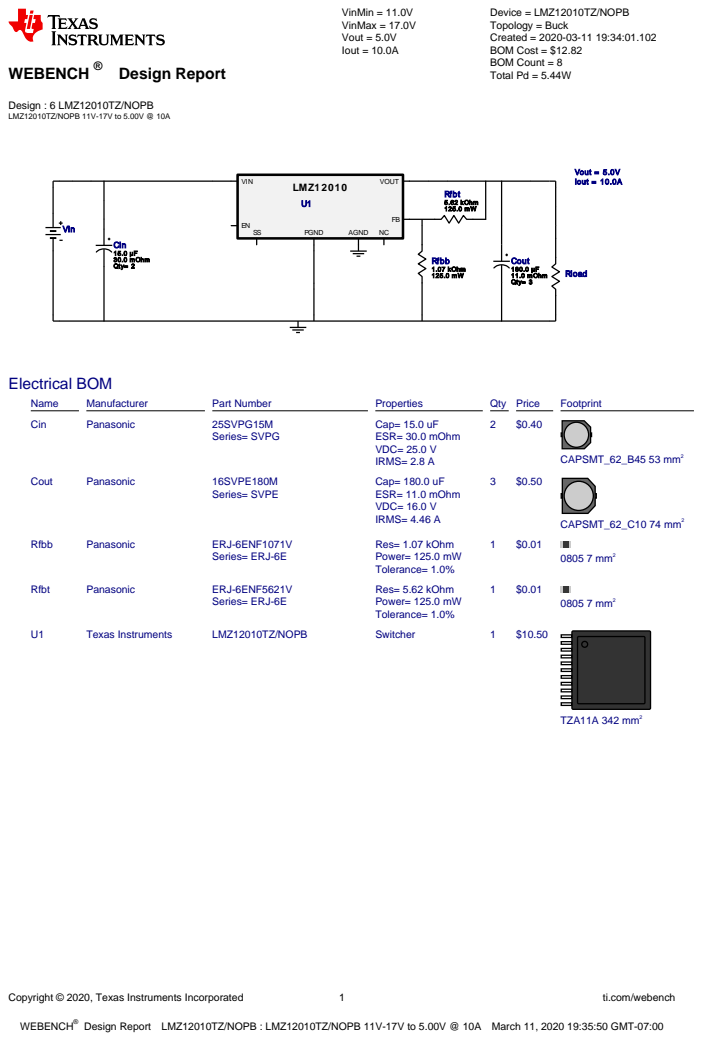
[picture p19: page 1]
Copyright © 2020, Texas Instruments Incorporated; ti.com/webench; WEBENCH®; Design : 6 LMZ12010TZ/NOPB LMZ12010TZ/NOPB 11V-17V to 5.00V @ 10A; VinMin = 11.0V VinMax = 17.0V Vout = 5.0V Iout = 10.0A; Device = LMZ12010TZ/NOPB Topology = Buck Created = 2020-03-11 19:34:01.102 BOM Cost = $12.82 BOM Count = 8 Total Pd = 5.44W; Cin 15.0 µF 30.0 mOhm Qty= 2; Vout = 5.0V Iout = 10.0A; Rfbb 1.07 kOhm 125.0 mW; LMZ12010; VIN; PGND; AGND; VOUT; Rfbt 5.62 kOhm 125.0 mW; Cout 180.0 µF 11.0 mOhm Qty= 3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

Design Report LMZ12010TZ/NOPB : LMZ12010TZ/NOPB 11V-17V to 5.00V @ 10A March 11, 2020 19:35:50 GMT-07:00

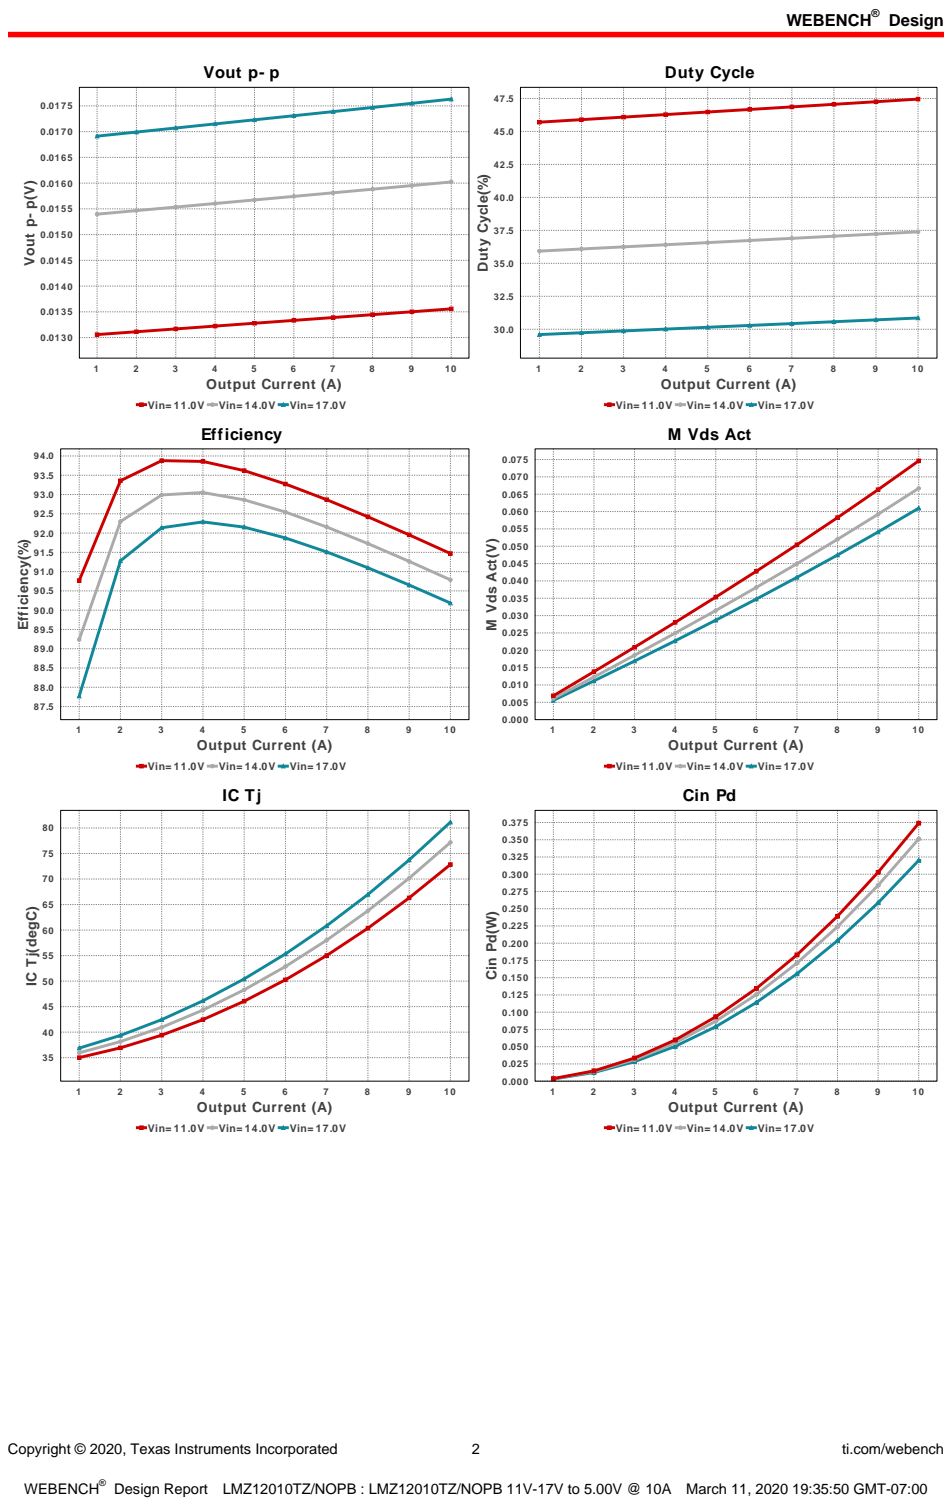
[picture p20: page 2]
Design; Copyright © 2020, Texas Instruments Incorporated; ti.com/webench; Vout p- p; 10 Output Current (A); Vout p- p(V); Duty Cycle; Duty Cycle(%); Efficiency(%); M Vds Act(V); Cin Pd; Cin Pd(W)

Vin= 11.0V Vin= 14.0V Vin= 17.0V
Efficiency

M Vds Act

IC Tj(degC)

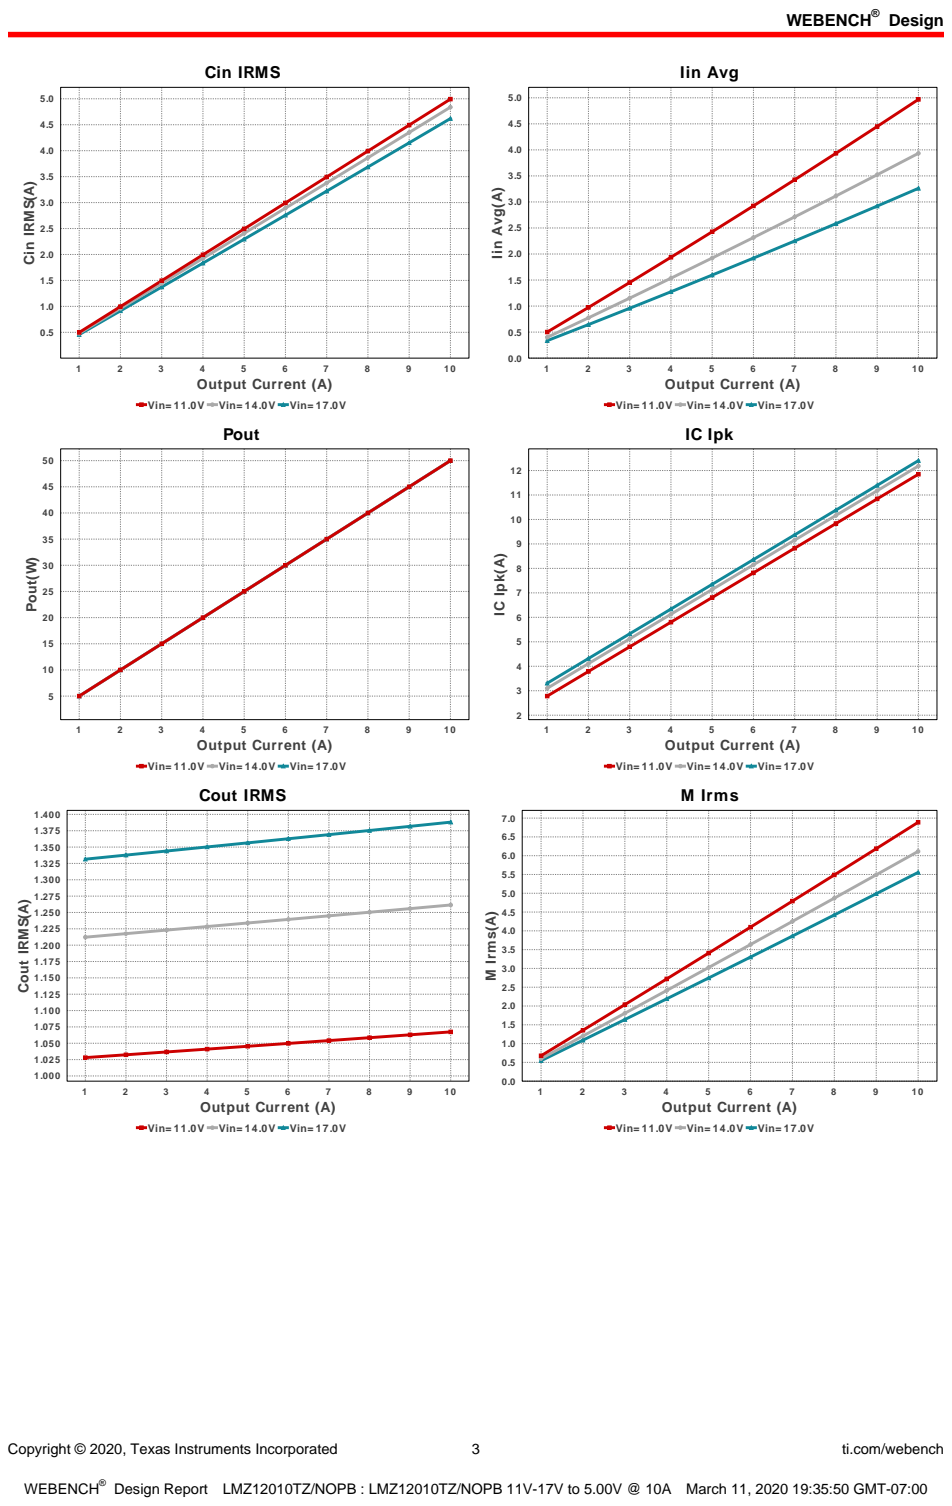
[picture p21: page 3]
Copyright © 2020, Texas Instruments Incorporated; ti.com/webench; Cin IRMS; 10 Output Current (A); Cin IRMS(A); Iin Avg; Iin Avg(A); Pout; Pout(W); IC Ipk; IC Ipk(A); Cout IRMS(A); M Irms; M Irms(A)

Vin= 11.0V Vin= 14.0V Vin= 17.0V

Cout IRMS

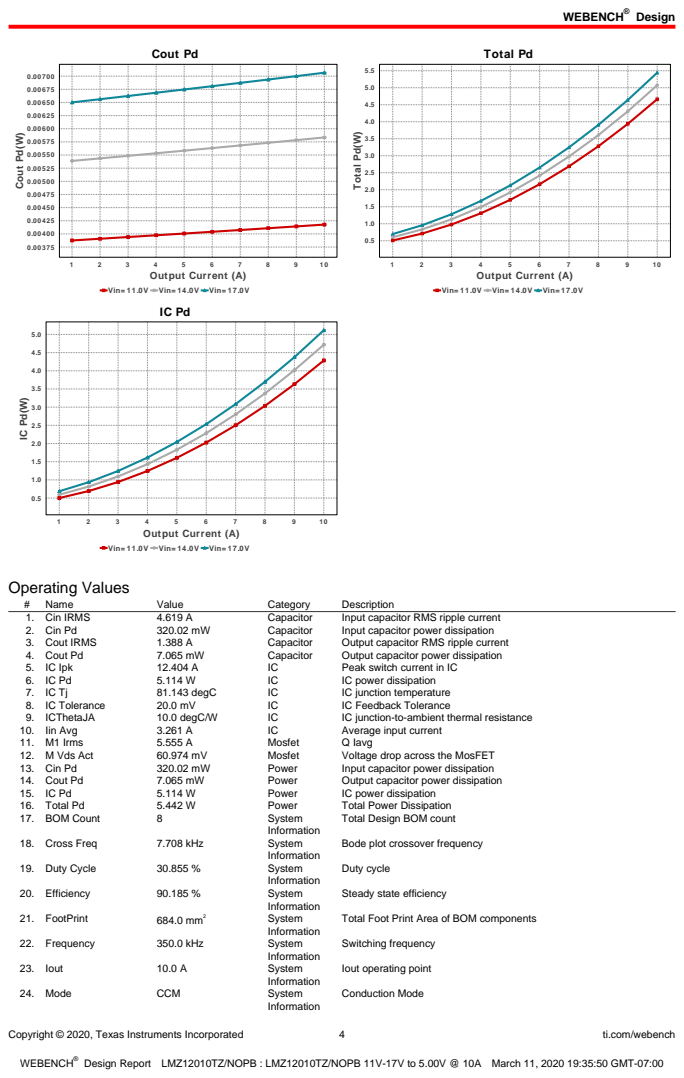
[picture p22: page 4]
Copyright © 2020, Texas Instruments Incorporated; ti.com/webench; Cout Pd; 10 Output Current (A); Cout Pd(W); Total Pd; Total Pd(W); Operating Values; Name; Value; Category; Description; 1. Cin IRMS; Capacitor; Input capacitor RMS ripple current; 2. Cin Pd; Input capacitor power dissipation; 3. Cout IRMS; Output capacitor RMS ripple current; 4. Cout Pd; Output capacitor power dissipation; 5. IC Ipk; Peak switch current in IC; IC power dissipation; 81.143 degC; IC junction temperature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

Vin= 11.0V Vin= 14.0V Vin= 17.0V

Total Design BOM count

Bode plot crossover frequency

Steady state efficiency

Total Foot Print Area of BOM components

Iout operating point

Copyright © 2020, Texas Instruments Incorporated | 5 | ti.com/webench
# | Name | Value | Category | Description

25. Phase Marg | 49.488 deg | System
| | | Information | Bode Plot Phase Margin
26. Pout | 50.0 W | System
| | | Information | Total output power
27. Total BOM | $12.82 | System
| | | Information | Total BOM Cost
28. Vin | 17.0 V | System
| | | Information | Vin operating point
29. Vout | 5.0 V | System
| | | Information | Operational Output Voltage
30. Vout Actual | 5.002 V | System
| | | Information | Vout Actual calculated based on selected voltage divider resistors
31. Vout Tolerance | 4.24 % | System
| | | Information | Vout Tolerance based on IC Tolerance (no load) and voltage divider resistors if applicable
32. Vout p-p | 17.631 mV | System
| | | Information | Peak-to-peak output ripple voltage

## Design Inputs

Name | Value | Description
Iout | 10.0 | Maximum Output Current
VinMax | 17.0 | Maximum input voltage
VinMin | 11.0 | Minimum input voltage
Vout | 5.0 | Output Voltage
| base_pn | | LMZ12010 | Base Product Number
source | DC | Input Source Type
Ta | 30.0 | Ambient temperature


Copyright © 2020, Texas Instruments Incorporated | 6 | ti.com/webench

## Assembly

## Component Testing

Some published data on components in datasheets such as Capacitor ESR and Inductor DC resistance is based on conservative values that will guarantee that the components always exceed the specification. For design purposes it is usually better to work with typical values. Since this data is not always available it is a good practice to measure the Capacitance and ESR values of Cin and Cout, and the inductance and DC resistance of L1 before assembly of the board. Any large discrepancies in values should be electrically simulated in WEBENCH to check for instabilities and thermally simulated in WebTHERM to make sure critical temperatures are not exceeded.

## Soldering Component to Board

If board assembly is done in house it is best to tack down one terminal of a component on the board then solder the other terminal. For surface mount parts with large tabs, such as the DPAK, the tab on the back of the package should be pre-tinned with solder, then tacked into place by one of the pins. To solder the tab town to the board place the iron down on the board while resting against the tab, heating both surfaces simultaneously. Apply light pressure to the top of the plastic case until the solder flows around the part and the part is flush with the PCB. If the solder is not flowing around the board you may need a higher wattage iron (generally 25W to 30W is enough).

## Initial Startup of Circuit

It is best to initially power up the board by setting the input supply voltage to the lowest operating input voltage 11.0V and set the input supply's current limit to zero. With the input supply off connect up the input supply to Vin and GND. Connect a digital volt meter and a load if needed to set the minimum Iout of the design from Vout and GND. Turn on the input supply and slowly turn up the current limit on the input supply.
If the voltage starts to rise on the input supply continue increasing the input supply current limit while watching the output voltage. If the current increases on the input supply, but the voltage remains near zero, then there may be a short or a component misplaced on the board. Power down the board and visually inspect for solder bridges and recheck the diode and capacitor polarities. Once the power supply circuit is operational then more extensive testing may include full load testing, transient load and line tests to compare with simulation results.

## Load Testing

The setup is the same as the initial startup, except that an additional digital voltmeter is connected between Vin and GND, a load is connected between Vout and GND and a current meter is connected in series between Vout and the load. The load must be able to handle at least rated output power + 50% ( 7.5 watts for this design). Ideally the load is supplied in the form of a variable load test unit. It can also be done in the form of suitably large power resistors. When using an oscilloscope to measure waveforms on the prototype board, the ground leads of the oscilloscope probes should be as short as possible and the area of the loop formed by the ground lead should be kept to a minimum. This will help reduce ground lead inductance and eliminate EMI noise that is not actually present in the circuit.

## Design Assistance

1. The 2nd Gen Modules are very easy to use and just need a basic design using a resistor divider at the feedback and input and output caps to work. To design for UVLO you could click on the drop down menu in the 'Change Inputs' menu and select the 'UVLO Enabled Design'. The internal softstart time is set at 1.6mSec. If a longer softstart time is desired, you could change the preset to the desired amount and click on 'Submit'. Webench will then add an external softstartcap to the schematic.
2. Master key : 3ADD0724B632D79A[v1]
3. LMZ12010 Product Folder : http://www.ti.com/product/LMZ12010 : contains the data sheet and other resources.

Copyright © 2020, Texas Instruments Incorporated | 7 | ti.com/webench

Important Notice and Disclaimer

TI provides technical and reliability data (including datasheets), design resources (including reference designs), application or other design advice, web tools, safety information, and other resources AS IS and with all faults, and disclaims all warranties. These resources are intended for skilled developers designing with TI products. You are solely responsible for (1) selecting the appropriate TI products for your application, (2) designing, validating and testing your application, and (3) ensuring your application meets applicable standards, and any other safety, security, or other requirements.

These resources are subject to change without notice. TI grants you permission to use these resources only for development of an application that uses the TI products described in the resource. Other reproduction and display of these resources is prohibited. No license is granted to any other TI intellectual property right or to any third party intellectual property right. TI disclaims responsibility for, and you will fully indemnify TI and its representatives against, any claims, damages, costs, losses, and liabilities arising out of your use of these resources.

Providing these resources does not expand or otherwise alter TI's applicable Terms of Sale or other applicable terms available either on ti.com or provided in conjunction with TI products.
