angler-robotics/angler-electrical/Hardware/V2/Block Diagrams/Proto board connections.pdf

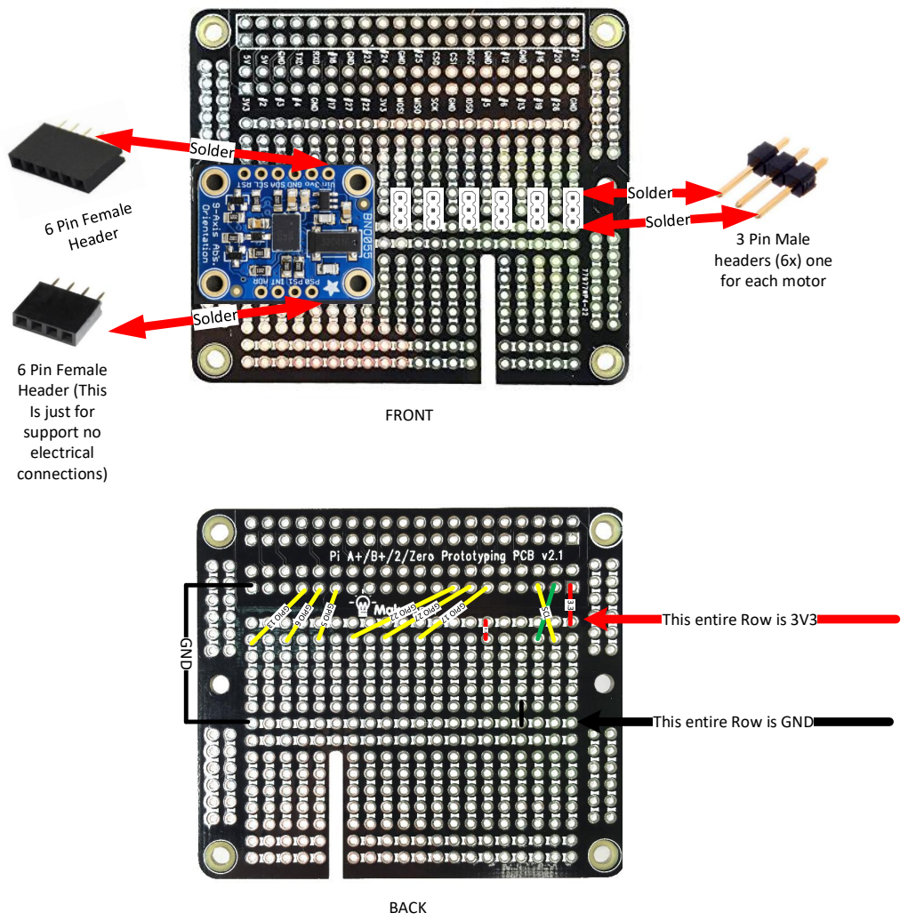
[picture p23: page 1]
BACK; FRONT; Solder; GND

3 Pin Male
headers (6x) one
for each motor

6 Pin Female
Header (This
Is just for
support no
electrical
connections)

This entire Row is 3V3

This entire Row is GND
