angler-robotics/angler-electrical/Hardware/V2/Main PCB V2/Schematics/Angler_Main_PCB_V2_Schematic.pdf

# Cover Page

# REVISION INDEX

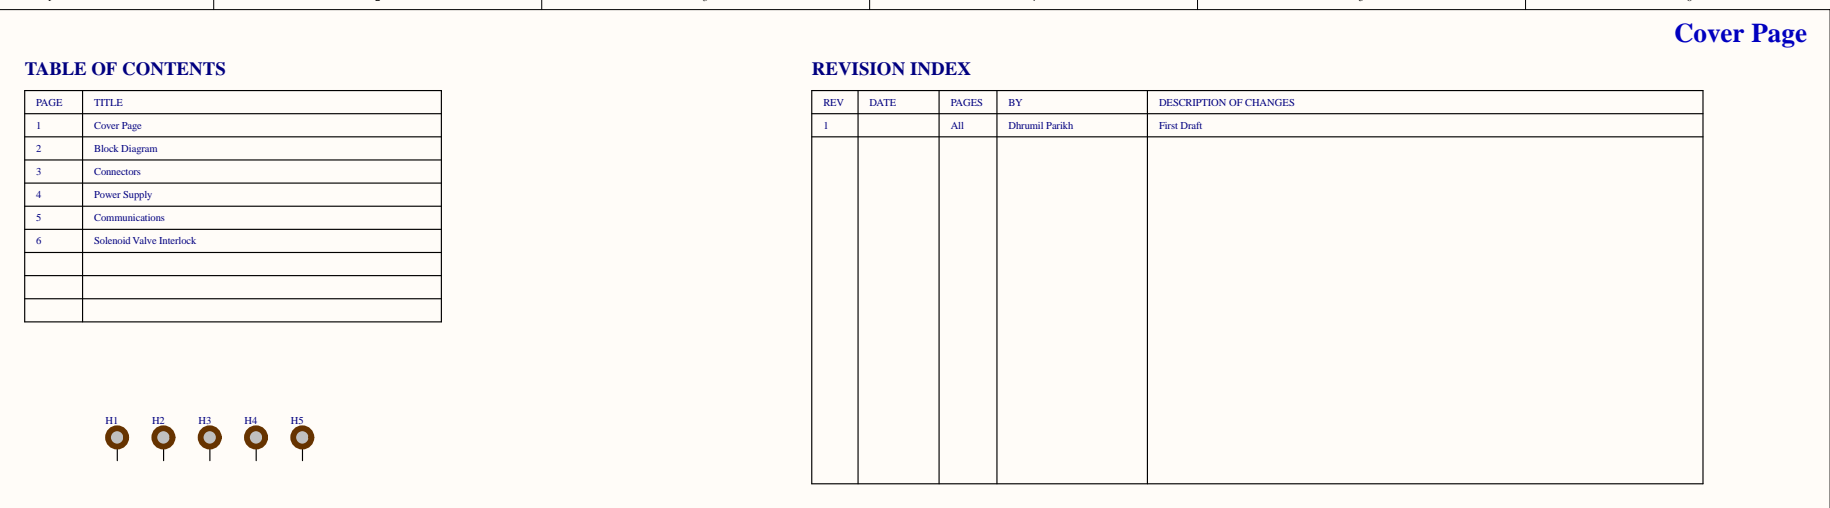
[picture p24: page 1]
Cover Page; S1_Cover_Page.SchDoc; Title:; Size:; Date: File:; Rev:; Sheet; Dhrumil Parikh; Project Lead:; Project:; DrawnBy:; 200 University Ave W Waterloo, ON N2L 3G1, Canada; PAGE; TITLE; Block Diagram; Connectors; Power Supply; Communications

TABLE OF CONTENTS

REV | DATE | PAGES | BY | DESCRIPTION OF CHANGES

1 | | All | Dhrumil Parikh | First Draft

Solenoid Valve Interlock

D | D
C | C
B | B
A | A

Block Diagram

S2_Block_Diagram.SchDoc

Title:

Size:

Rev:

T

Dhrumil Parikh | Project Lead:

Project:

DrawnBy: | Dhrumil Parikh

# Block Diagram

200 University Ave W

# Connectors

# Battery Connection

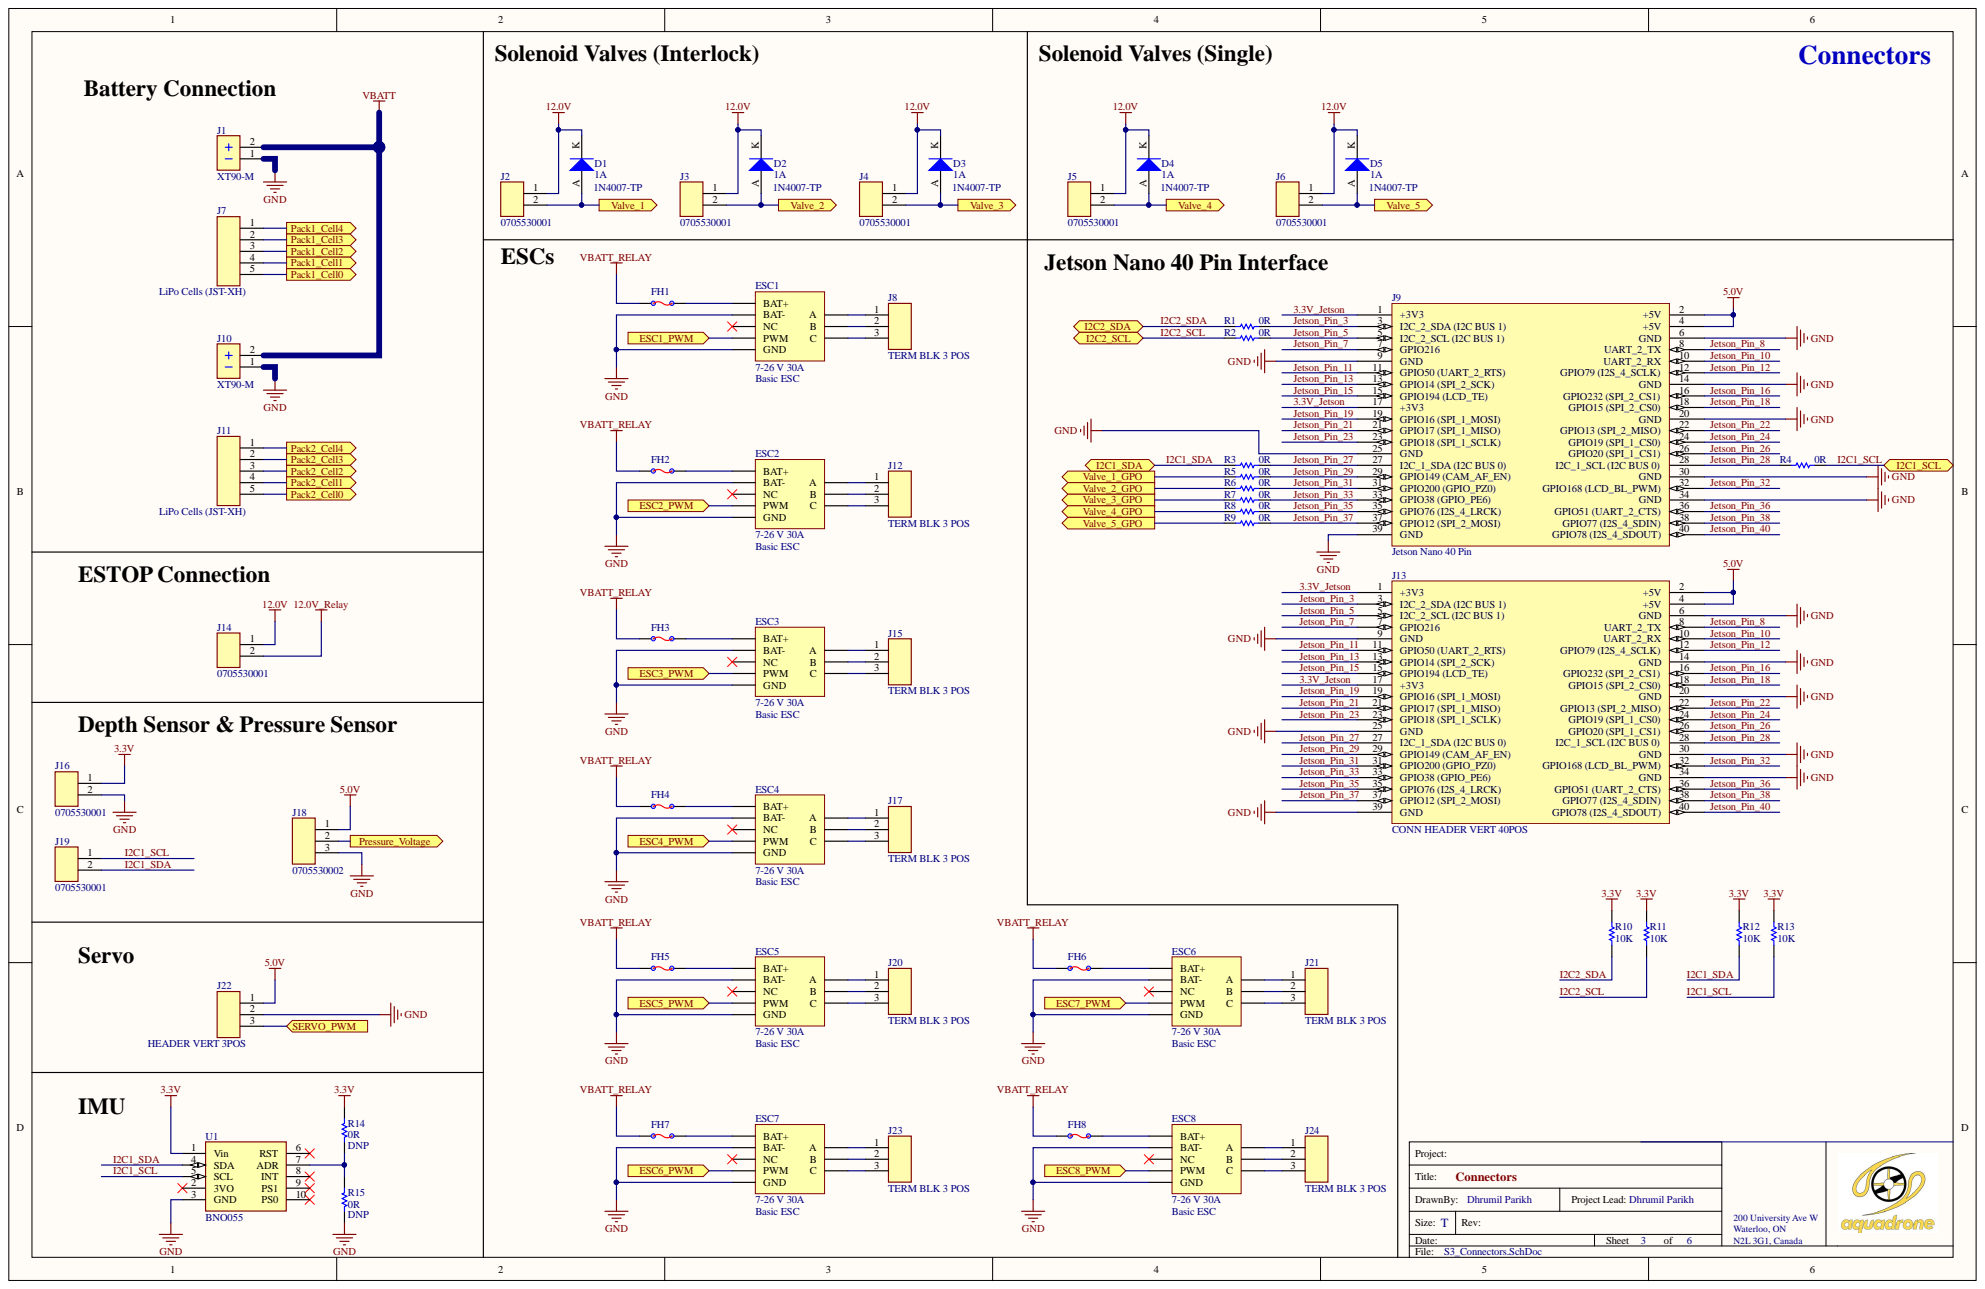
[picture p25: page 3]

LiPo Cells (JST-XH)

Depth Sensor & Pressure Sensor 3.3V

# Power Supply

12.0V

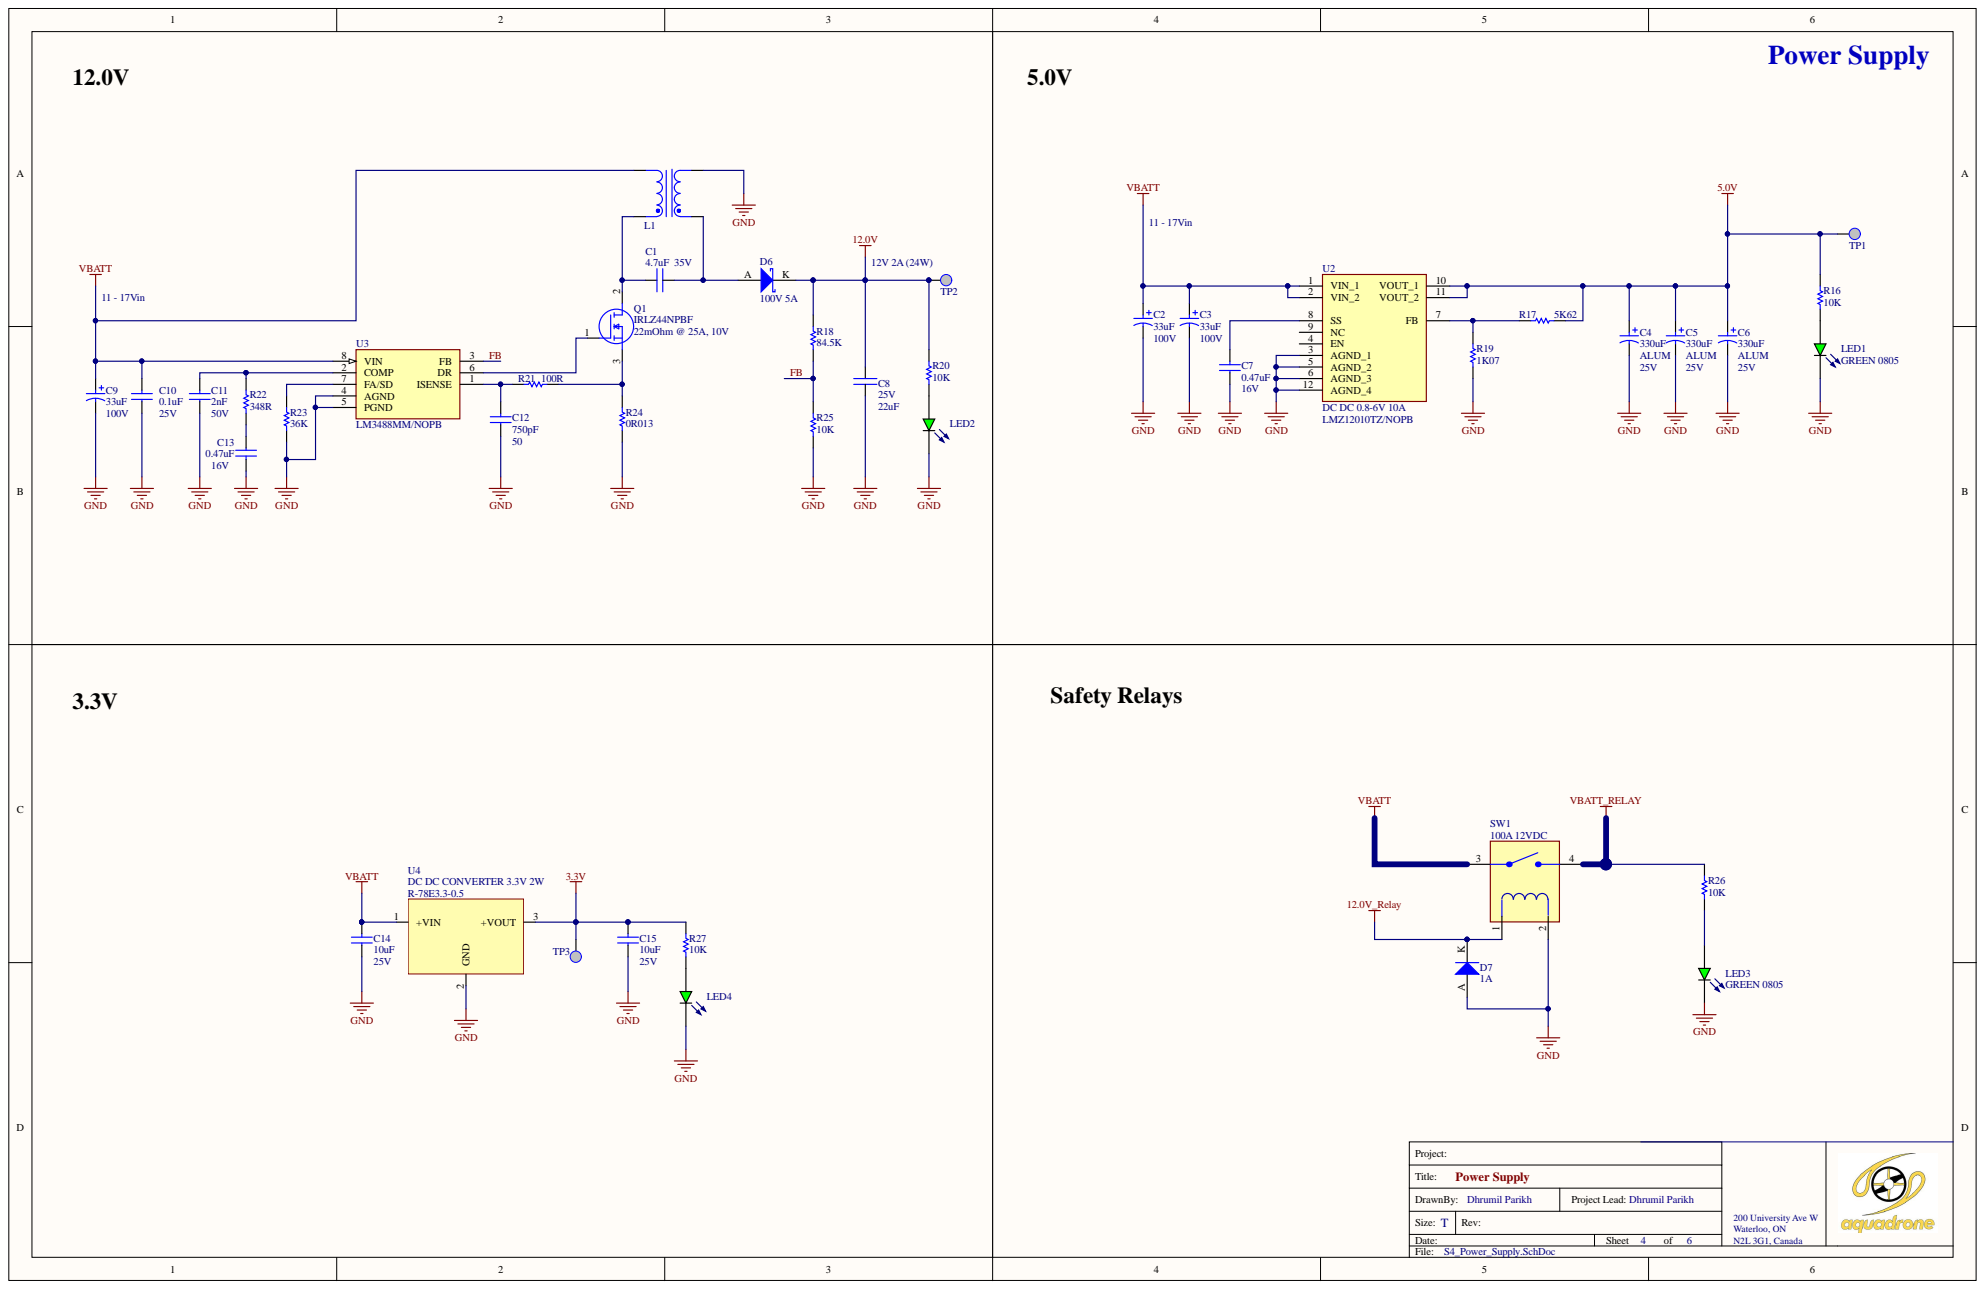
[picture p26: page 4]

# Communications

Battery Pack Monitoring ADC | I2C -> PWM

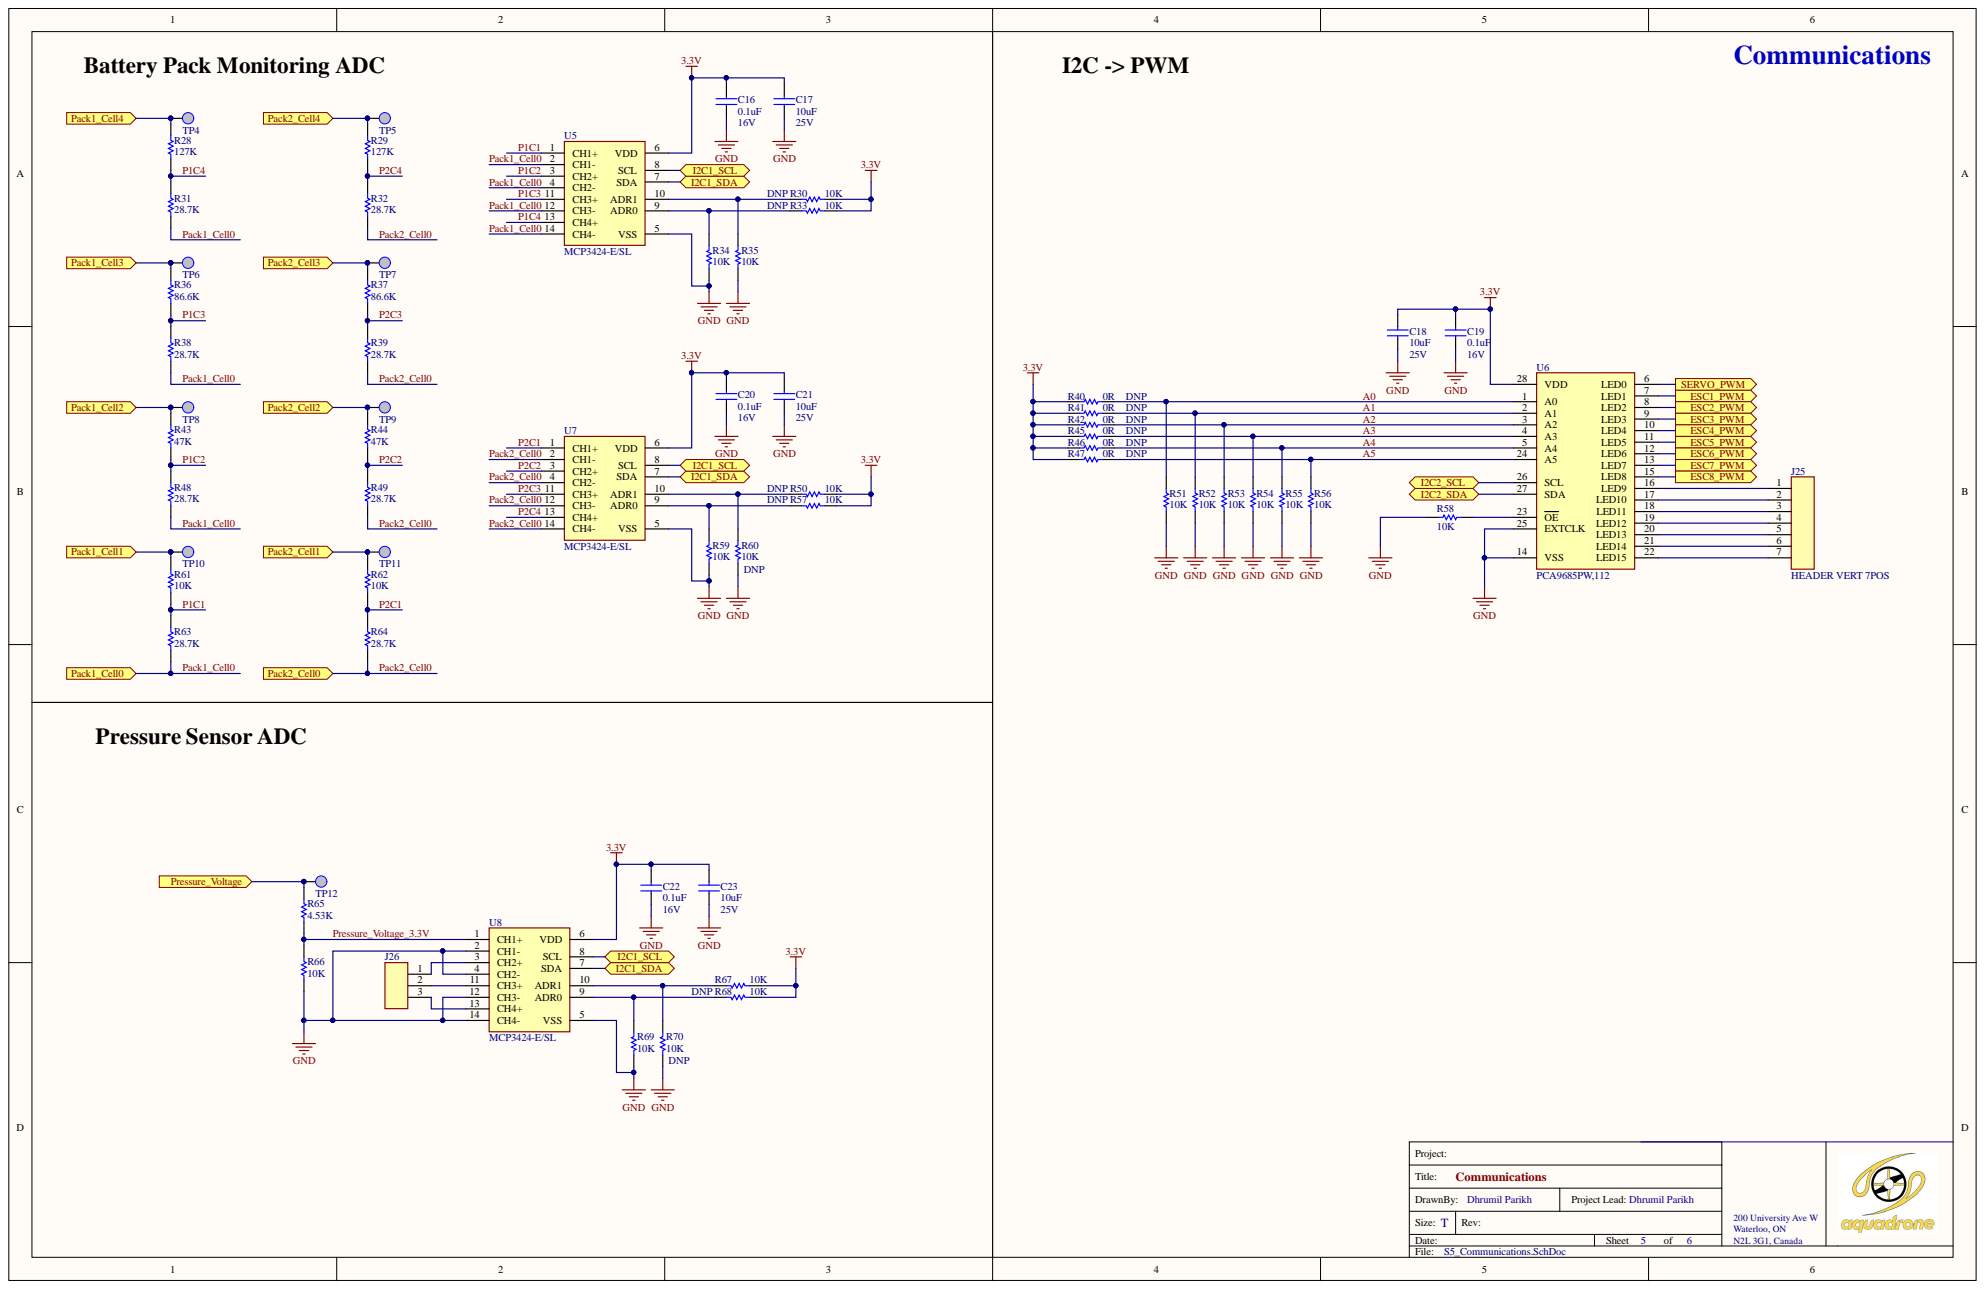
[picture p27: page 5]

GND GND GND

# Solenoid Valve Interlock

# Solenoid Valve Interlock Circuit

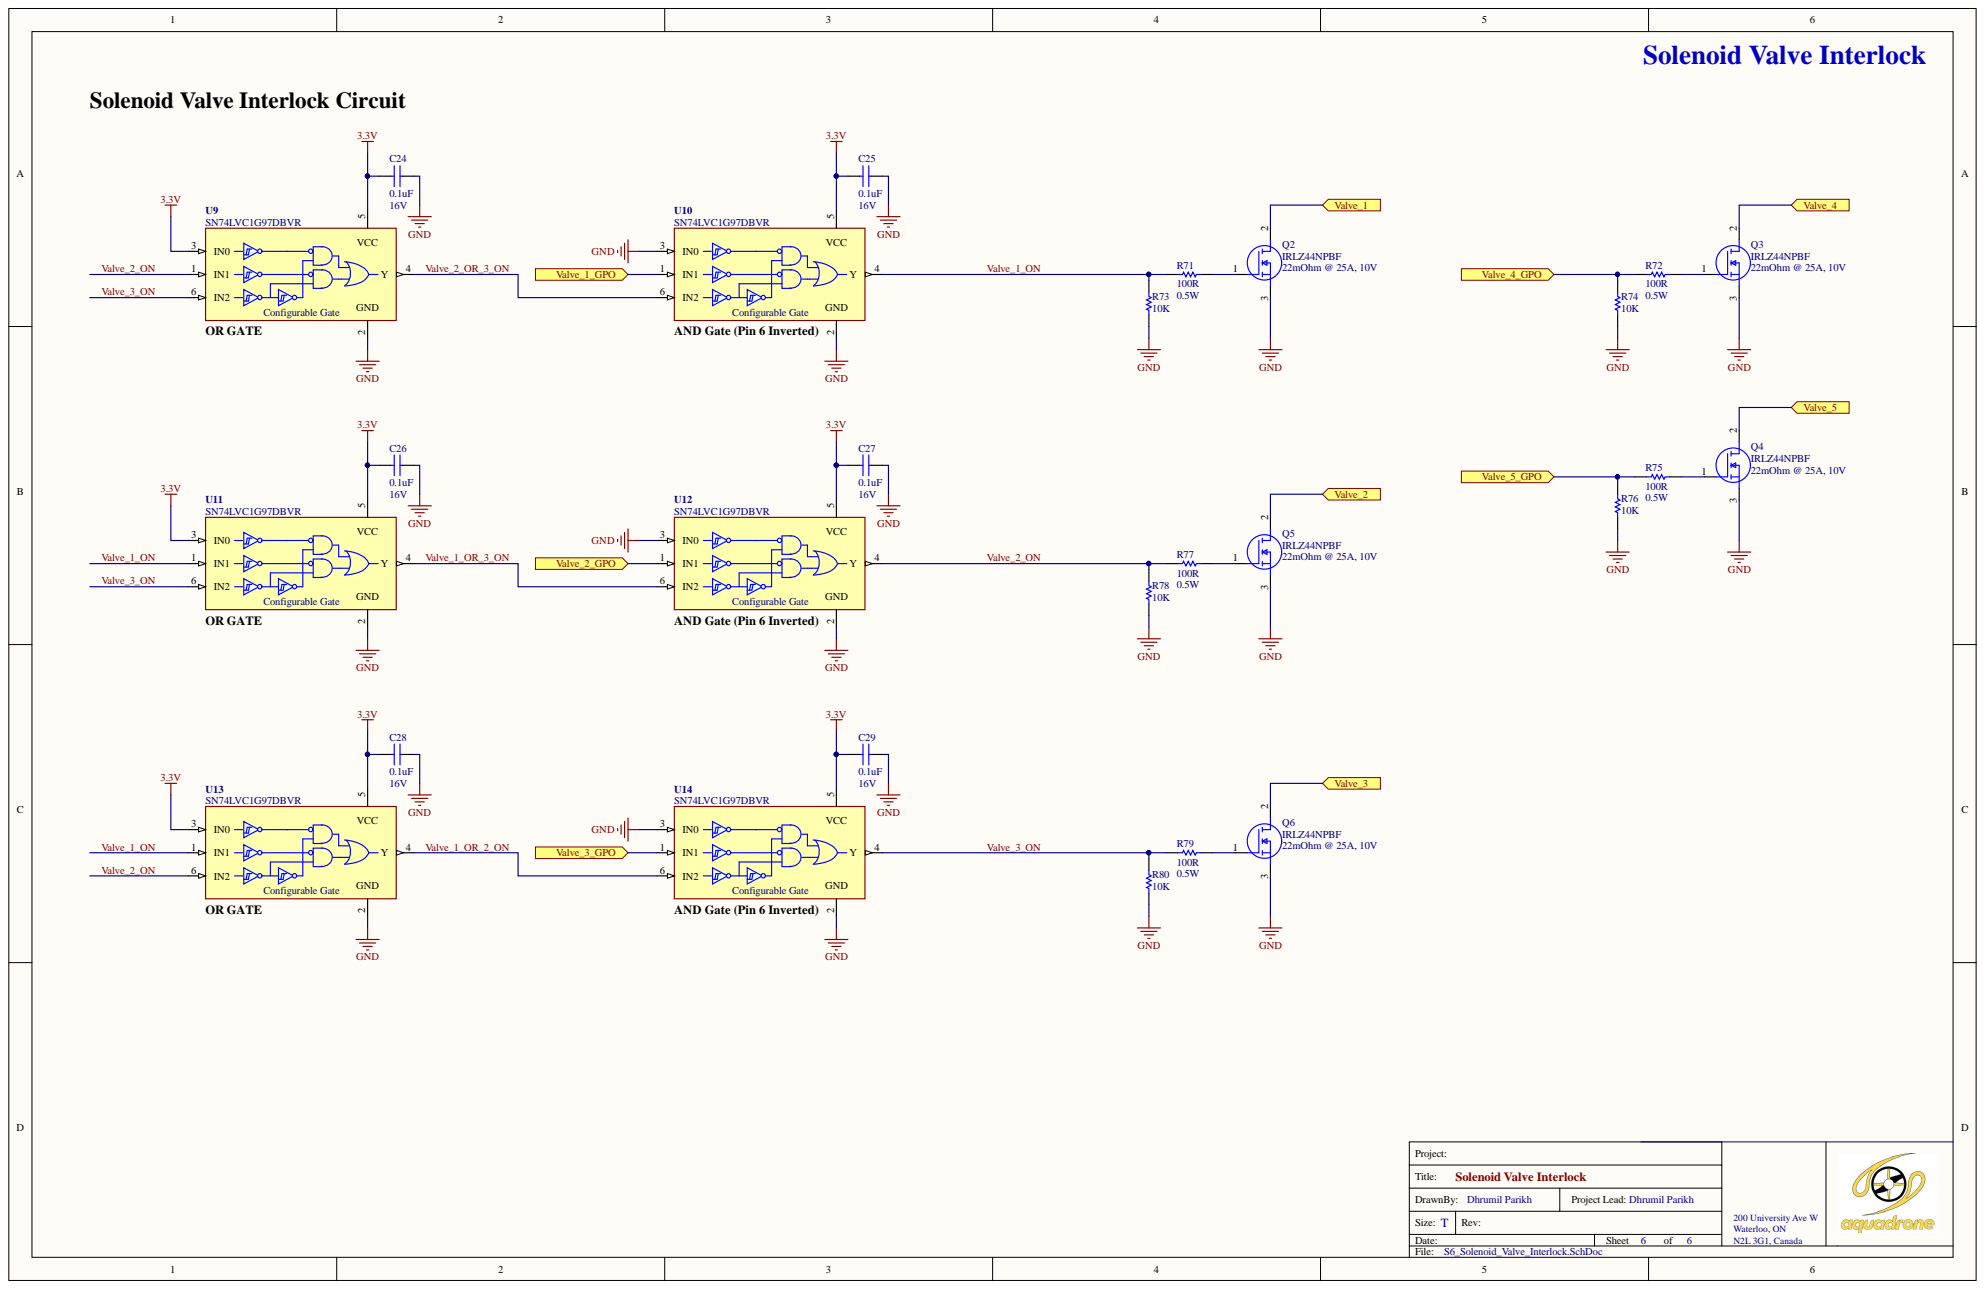
[picture p28: page 6]
