angler-robotics/angler-electrical/Hardware/V2/Main PCB V1/Schematics/Angler_Main_PCB_V1.pdf

# Cover Page

# REVISION INDEX

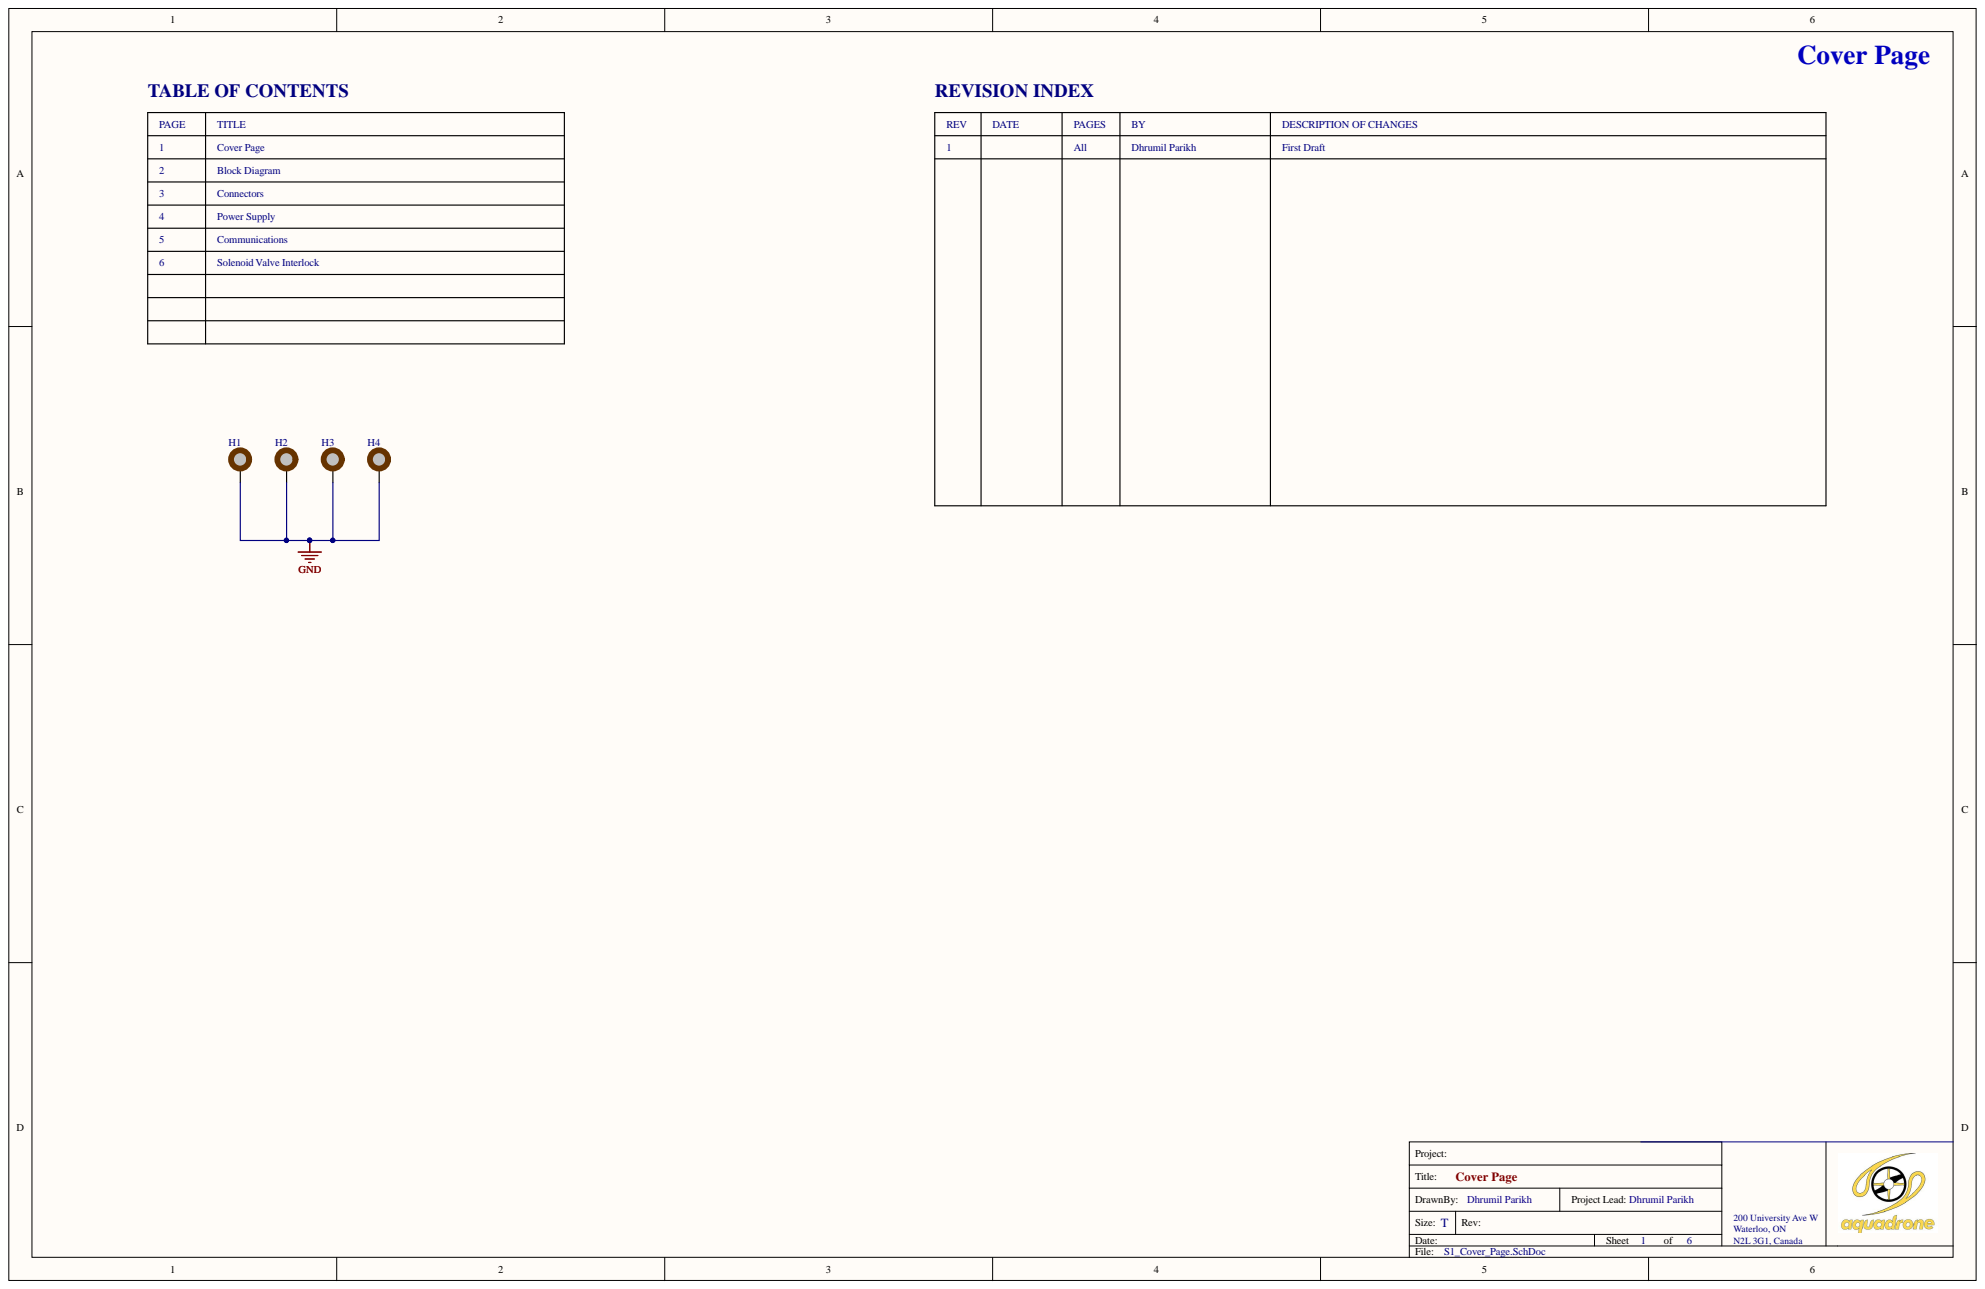
[picture p29: page 1]
Cover Page; S1_Cover_Page.SchDoc; Title:; Size:; Date: File:; Rev:; Sheet; Dhrumil Parikh; Project Lead:; Project:; DrawnBy:; 200 University Ave W Waterloo, ON N2L 3G1, Canada; PAGE; TITLE; Block Diagram; Connectors; Power Supply; Communications; GND

TABLE OF CONTENTS

REV | DATE | PAGES | BY | DESCRIPTION OF CHANGES

1 | | All | Dhrumil Parikh | First Draft

Solenoid Valve Interlock

# Block Diagram

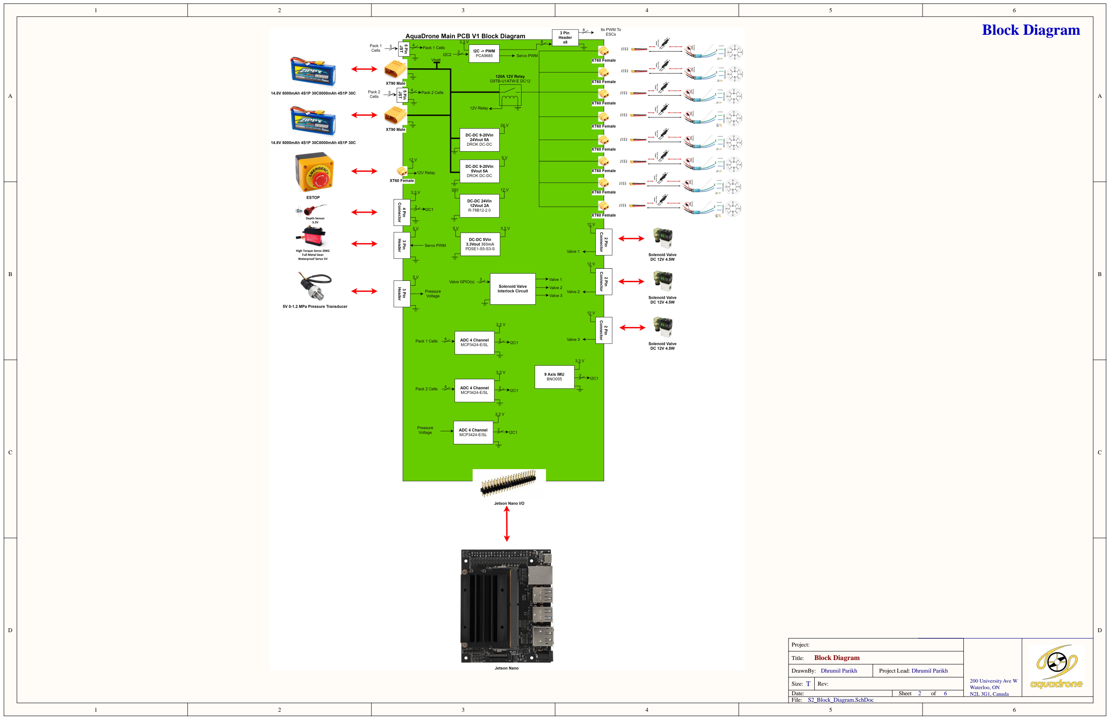
[picture p30: page 2]

D | D
C | C
B | B
A | A

Block Diagram

S2_Block_Diagram.SchDoc

Title:

Size:

Rev:

T

Dhrumil Parikh | Project Lead:

Project:

DrawnBy: | Dhrumil Parikh

200 University Ave W

# Connectors

# Battery Connection

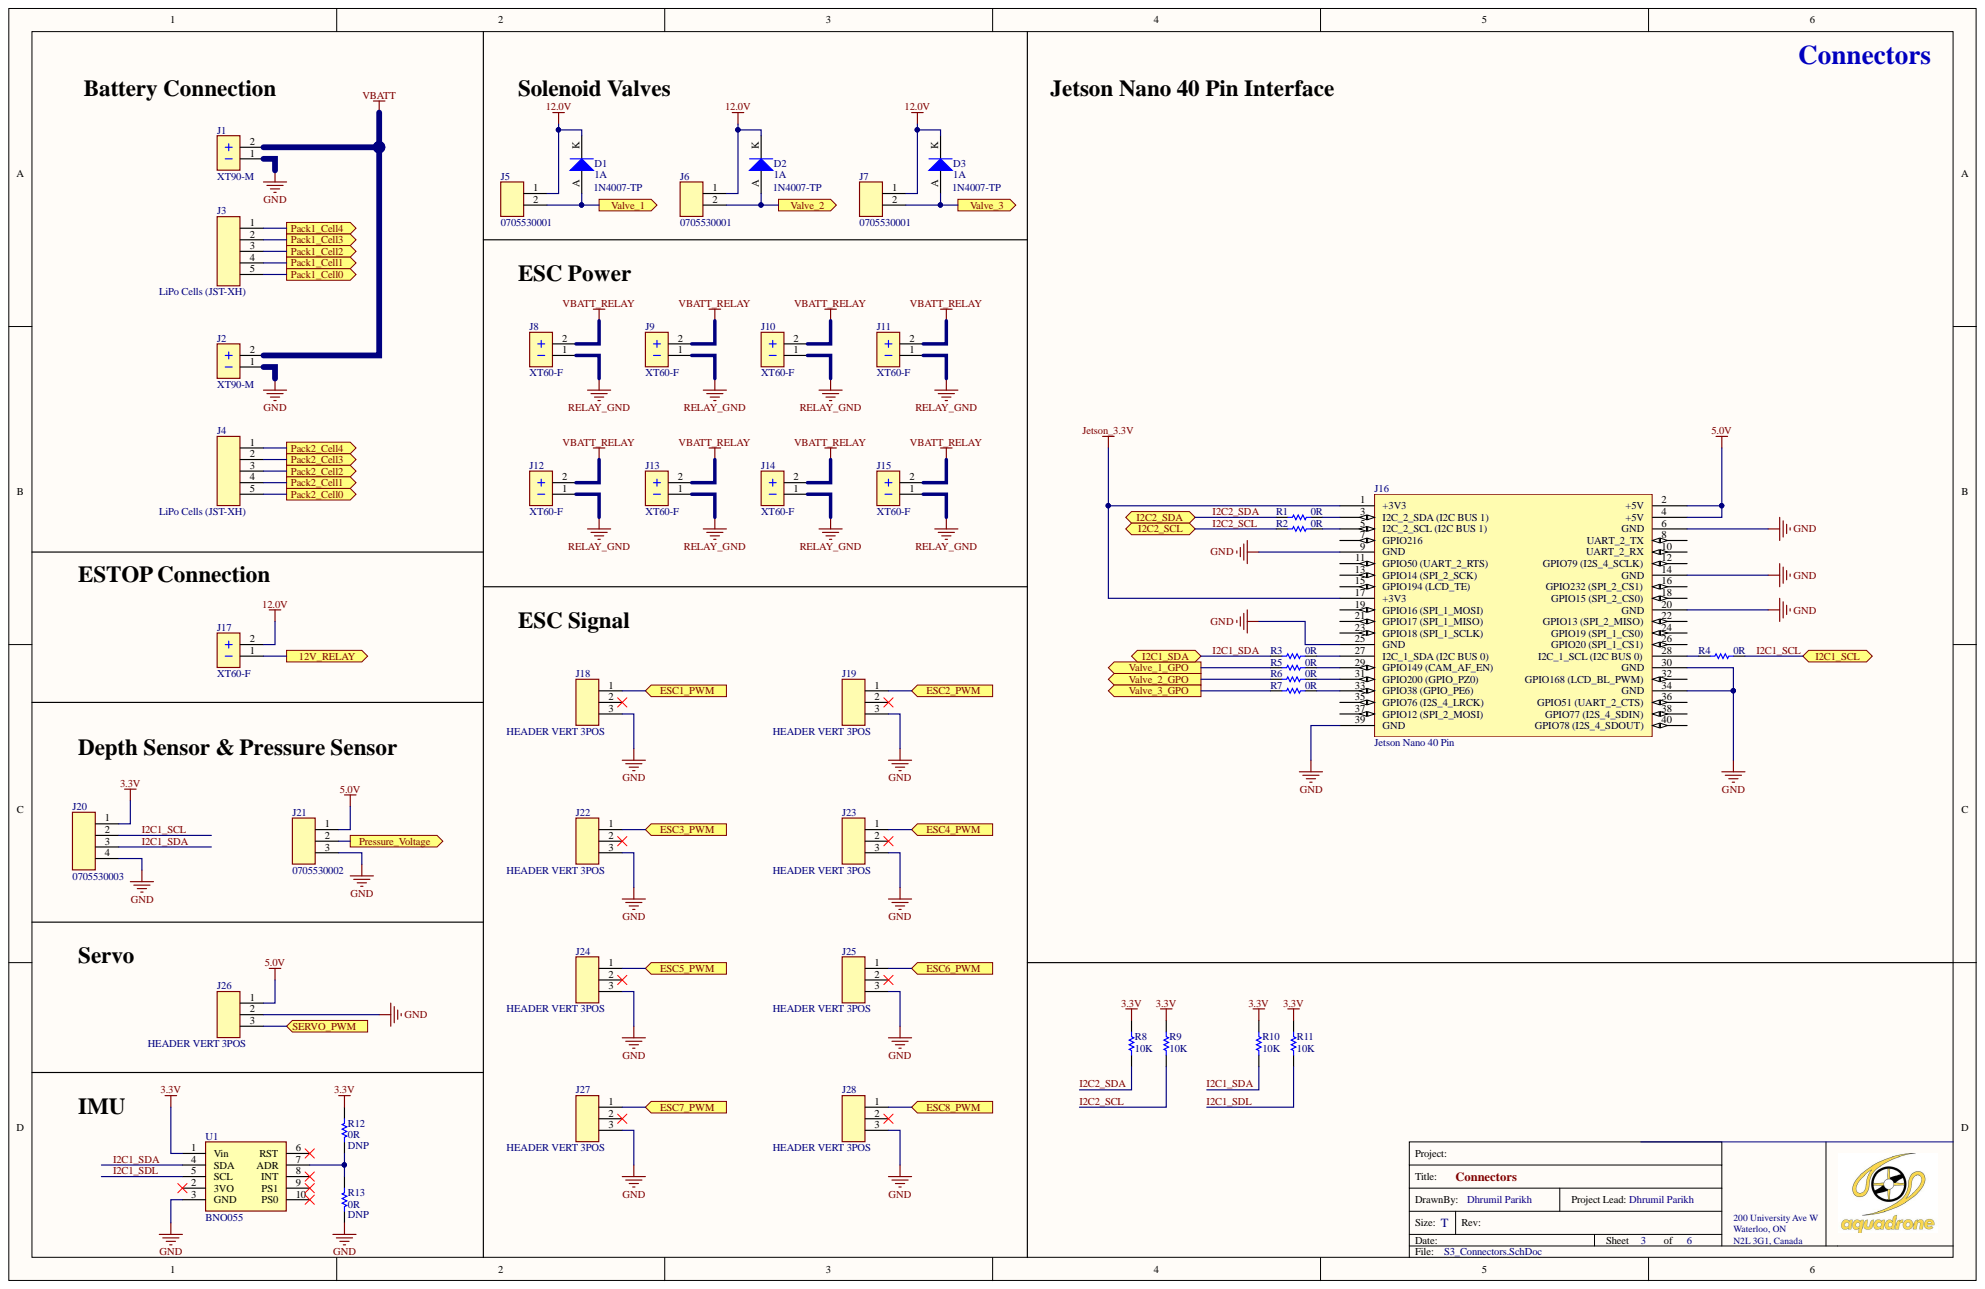
[picture p31: page 3]

Jetson Nano 40 Pin Interface

LiPo Cells (JST-XH)

Depth Sensor & Pressure Sensor

# Power Supply

24.0V

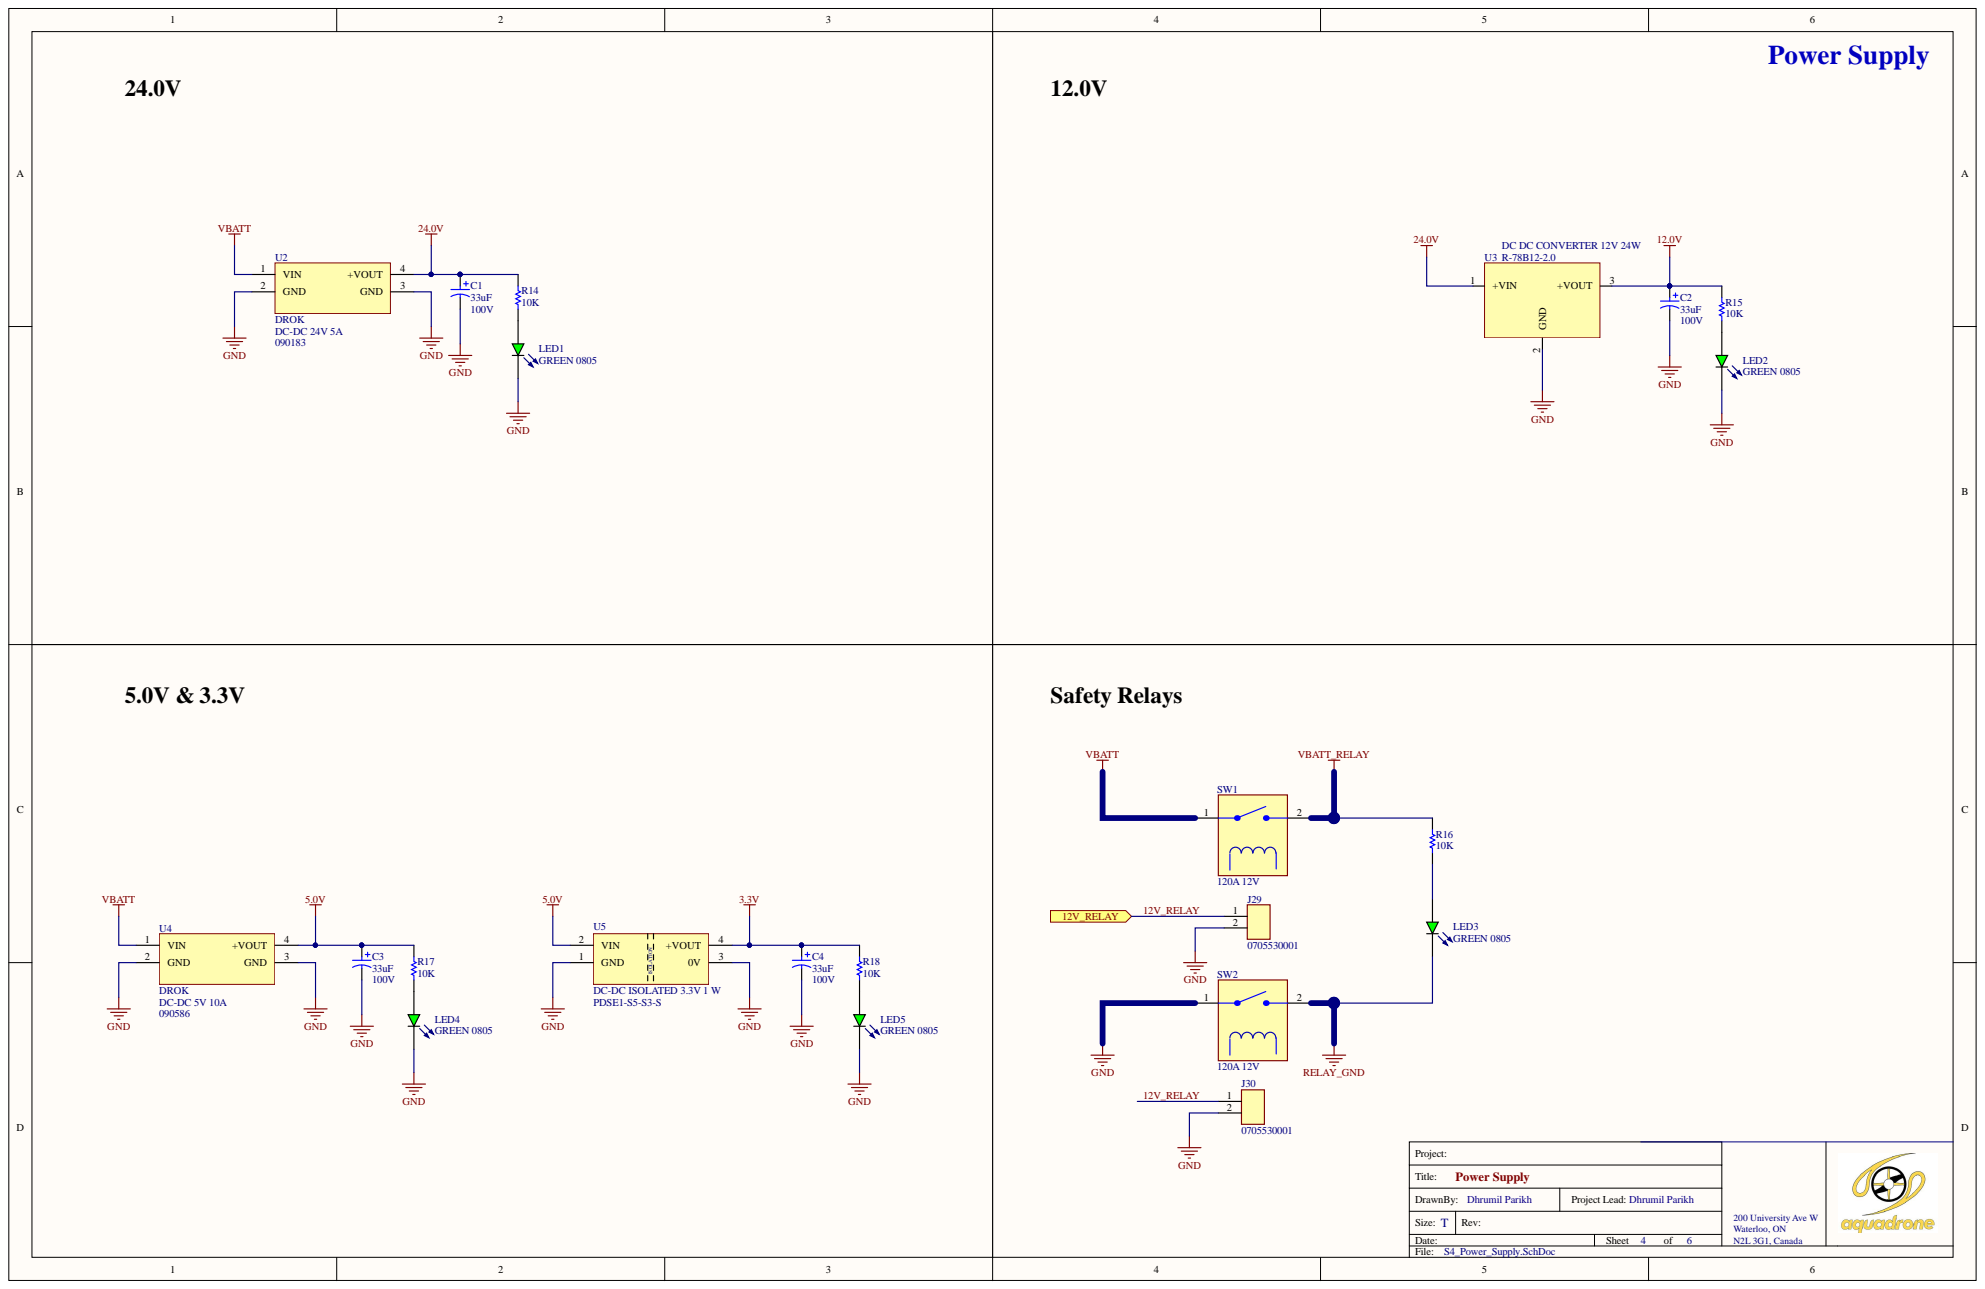
[picture p32: page 4]

# Communications

Battery Pack Monitoring ADC | I2C -> PWM

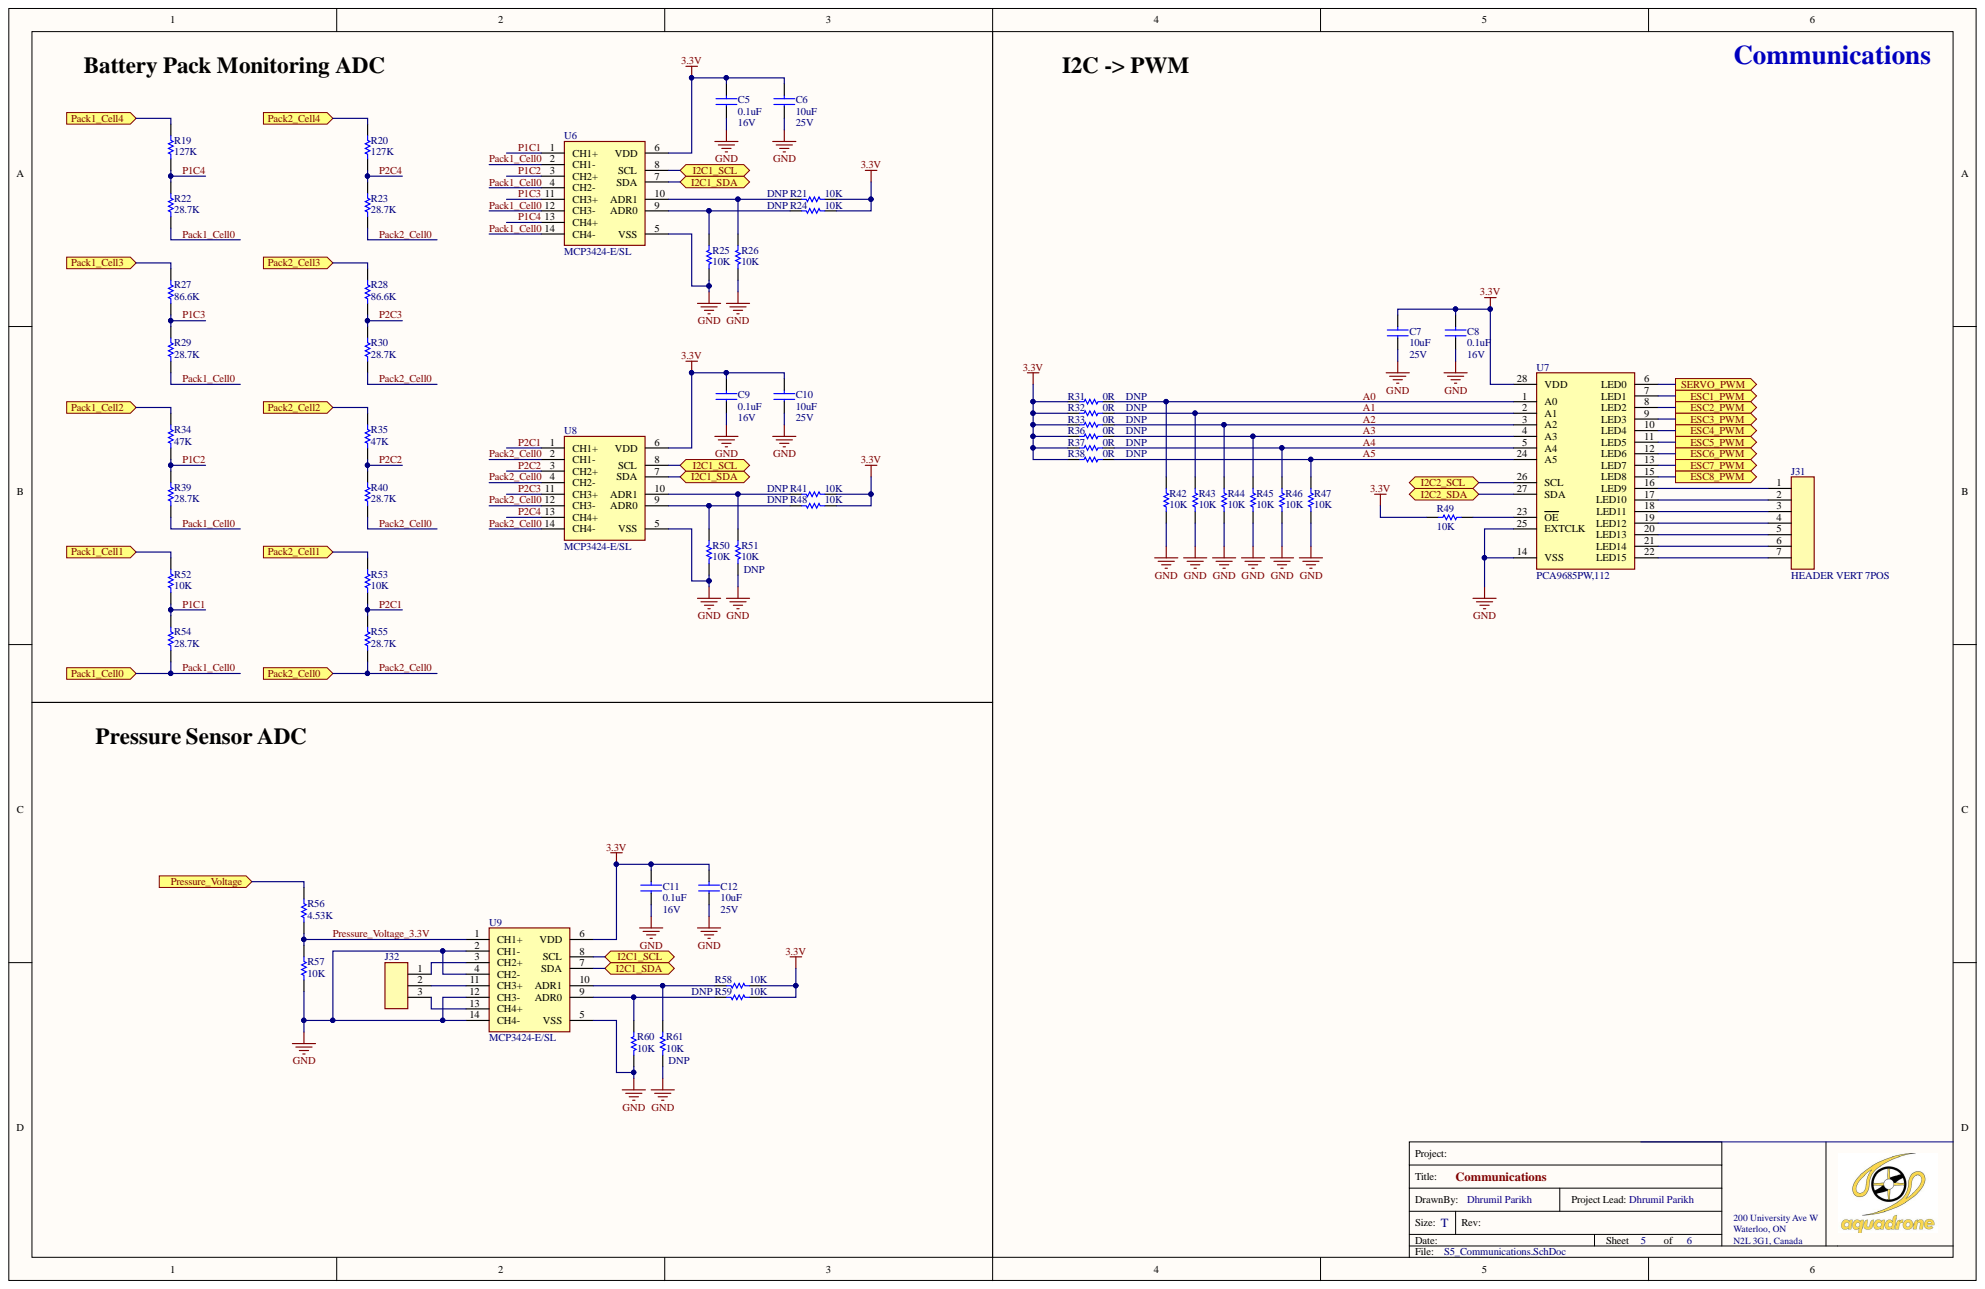
[picture p33: page 5]

GND GND GND

# Solenoid Valve Interlock

# Solenoid Valve Interlock Circuit

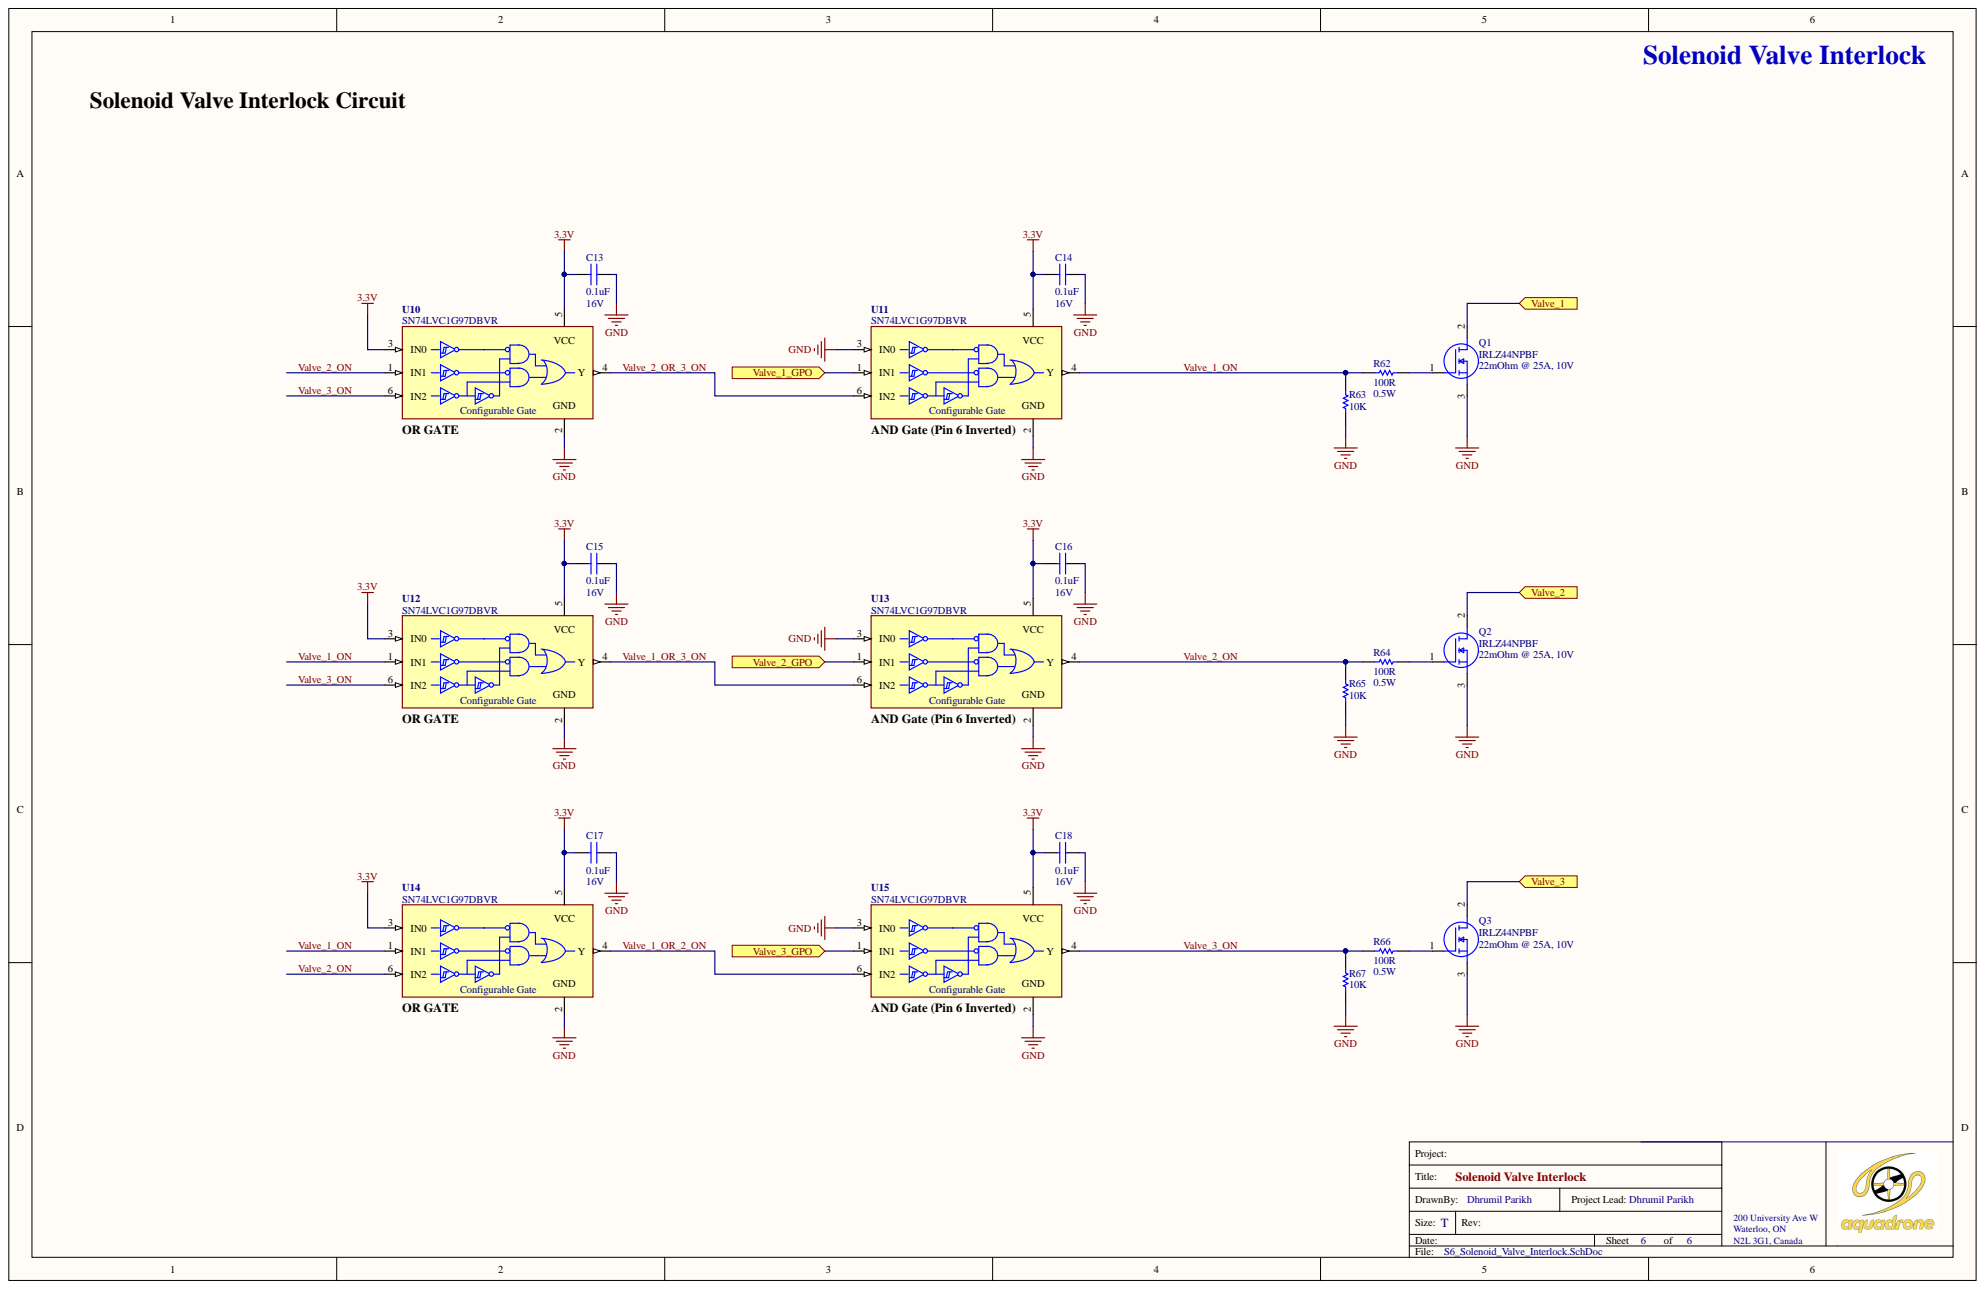
[picture p34: page 6]
