angler-robotics/angler-electrical/Hardware/V1/Schematics/Schematics.PDF

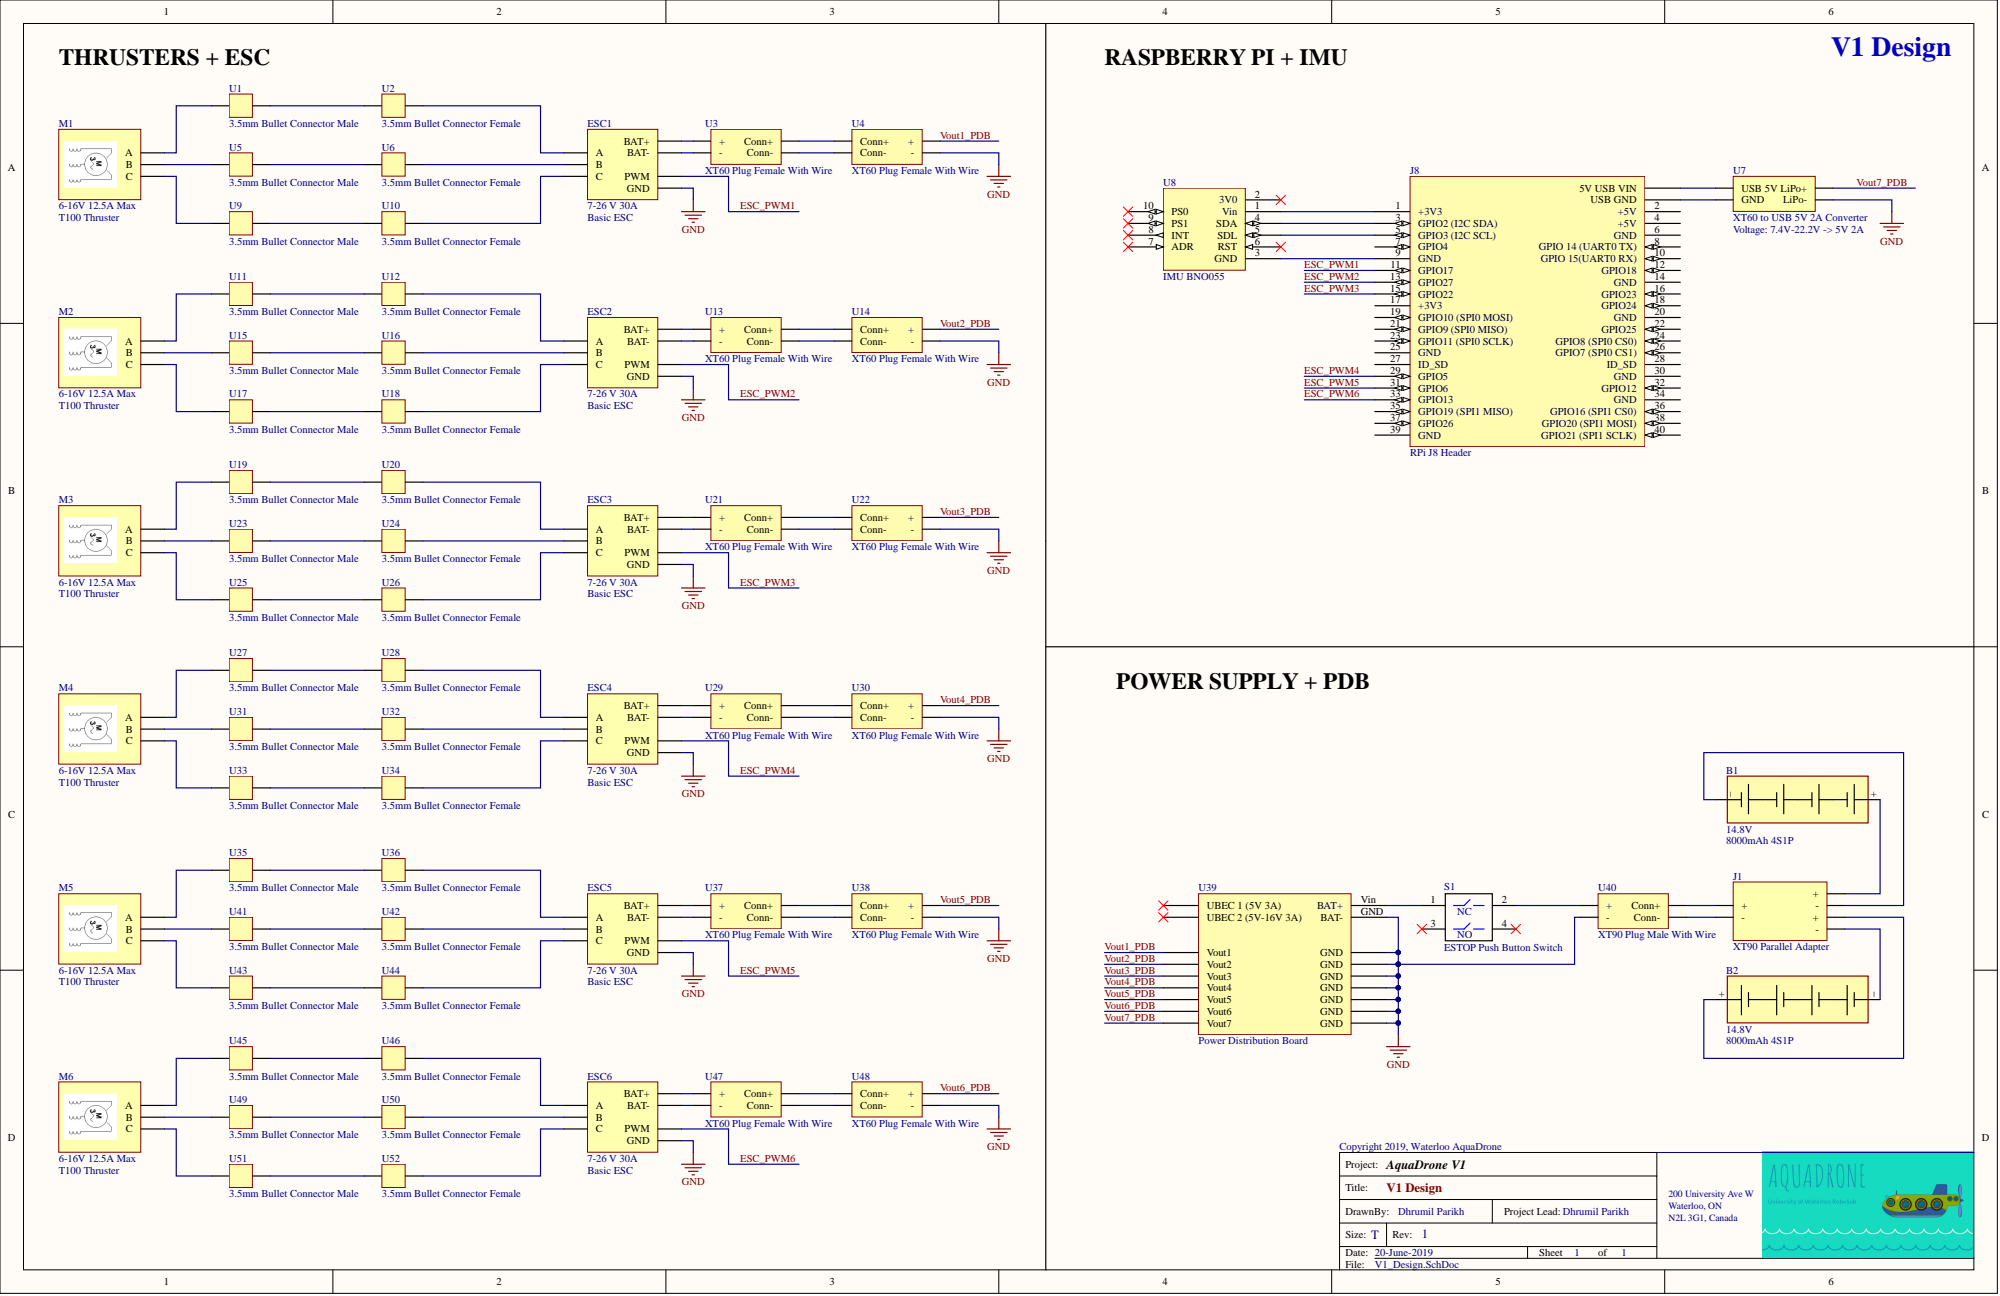
[picture p35: page 1]

DrawnBy: Dhrumil Parikh | Project Lead: Dhrumil Parikh
Size: T | 1 Rev:
