angler-robotics/angler-electrical/(list of files, drawings)

Other design files:
Hardware/Altium Libraries/Angler.SchLib
Hardware/Altium Libraries/AquaDrone.PcbLib
Hardware/Tutorial/Schematics/Tutorial.SchDoc
Hardware/Tutorial/Tutorial.PrjPcb
Hardware/V1/AnglerV1.PrjPcb
Hardware/V1/Schematics/V1_Design.SchDoc
Hardware/V2/Main PCB V1/Angler_Main_PCB_V1.PrjPcb
Hardware/V2/Main PCB V1/Schematics/S3_Connectors.SchDoc
Hardware/V2/Main PCB V1/Schematics/S4_Power_Supply.SchDoc
Hardware/V2/Main PCB V1/Schematics/S5_Communications.SchDoc
Hardware/V2/Main PCB V1/Schematics/S6_Solenoid_Valve_Interlock.SchDoc
Hardware/V2/Main PCB V2/Angler_Main_PCB_V2.PrjPcb
Hardware/V2/Main PCB V2/Schematics/S1_Cover_Page.SchDoc
Hardware/V2/Main PCB V2/Schematics/S2_Block_Diagram.SchDoc
Hardware/V2/Main PCB V2/Schematics/S3_Connectors.SchDoc
Hardware/V2/Main PCB V2/Schematics/S4_Power_Supply.SchDoc
Hardware/V2/Main PCB V2/Schematics/S5_Communications.SchDoc
Hardware/V2/Main PCB V2/Schematics/S6_Solenoid_Valve_Interlock.SchDoc
