angler-robotics/angler-electrical/(commit log)

2019-09-13 Migrated from Grabcad
    [AquaDrone.PcbLib, AquaDrone.SchLib, AquaDroneV1.PrjPcb, Battery Parameters.xlsx, Motor PWM Width - Thrust Relation.xlsx, Motor Selection.xlsx, V1_Design.SchDoc]
2019-09-15 Restructured Directory
    [Motor PWM Width - Thrust Relation.xlsx]
2019-10-02 Added Tutorial Template
    [AquaDrone.PcbLib, AquaDrone.SchLib, Tutorial.PrjPcb, Tutorial.SchDoc]
2019-10-03 Added USB connector to library
    [AquaDrone.PcbLib, AquaDrone.SchLib, Tutorial.SchDoc]
2019-10-03 Schematic for Tut
    [AquaDrone.SchLib, Tutorial.PrjPcb, Tutorial.SchDoc]
2020-01-14 Main PCB V1 Design files
    [AquaDrone_Main_PCB_V1.GBL, AquaDrone_Main_PCB_V1.GBO, AquaDrone_Main_PCB_V1.GBP, AquaDrone_Main_PCB_V1.GBS, AquaDrone_Main_PCB_V1.GTL, AquaDrone_Main_PCB_V1.GTO, AquaDrone_Main_PCB_V1.GTP, AquaDrone_Main_PCB_V1.GTS]
2020-01-24 Updated BOM
    [AquaDrone.SchLib, AquaDrone_Main_PCB_V1.PrjPcb, AquaDrone_Main_PCB_V1_BOM.xlsx, Traces-1.27mm Thick-Copper.DXF, Traces-1.27mm Thick-Copper.SLDDRW]
2020-03-12 PCB V2 Updates
    [AquaDrone.SchLib]
2020-03-15 PCB V2 Placement Complete
    [AquaDrone.SchLib, AquaDrone_Main_PCB_V2.PrjPcb, AquaDrone_Main_PCB_V2.xlsx, S1_Cover_Page.SchDoc, S3_Connectors.SchDoc, S4_Power_Supply.SchDoc, S5_Communications.SchDoc, S6_Solenoid_Valve_Interlock.SchDoc]
2020-03-16 PCB V2 Fab Release
    [AquaDrone_Main_PCB_V2.PrjPcb, S5_Communications.SchDoc]
2020-03-16 Added Final PCBV2 Step File
2020-03-18 Final PCB V2 Ready for fab
    [AquaDrone_Main_PCB_V2.PrjPcb, AquaDrone_Main_PCB_V2.xlsx]
2022-04-12 Update naming to match new team name
    [Angler.SchLib, AnglerV1.PrjPcb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]
